orkiman/glueControllerEsp32S3_48V/hardware/schematics.pdf

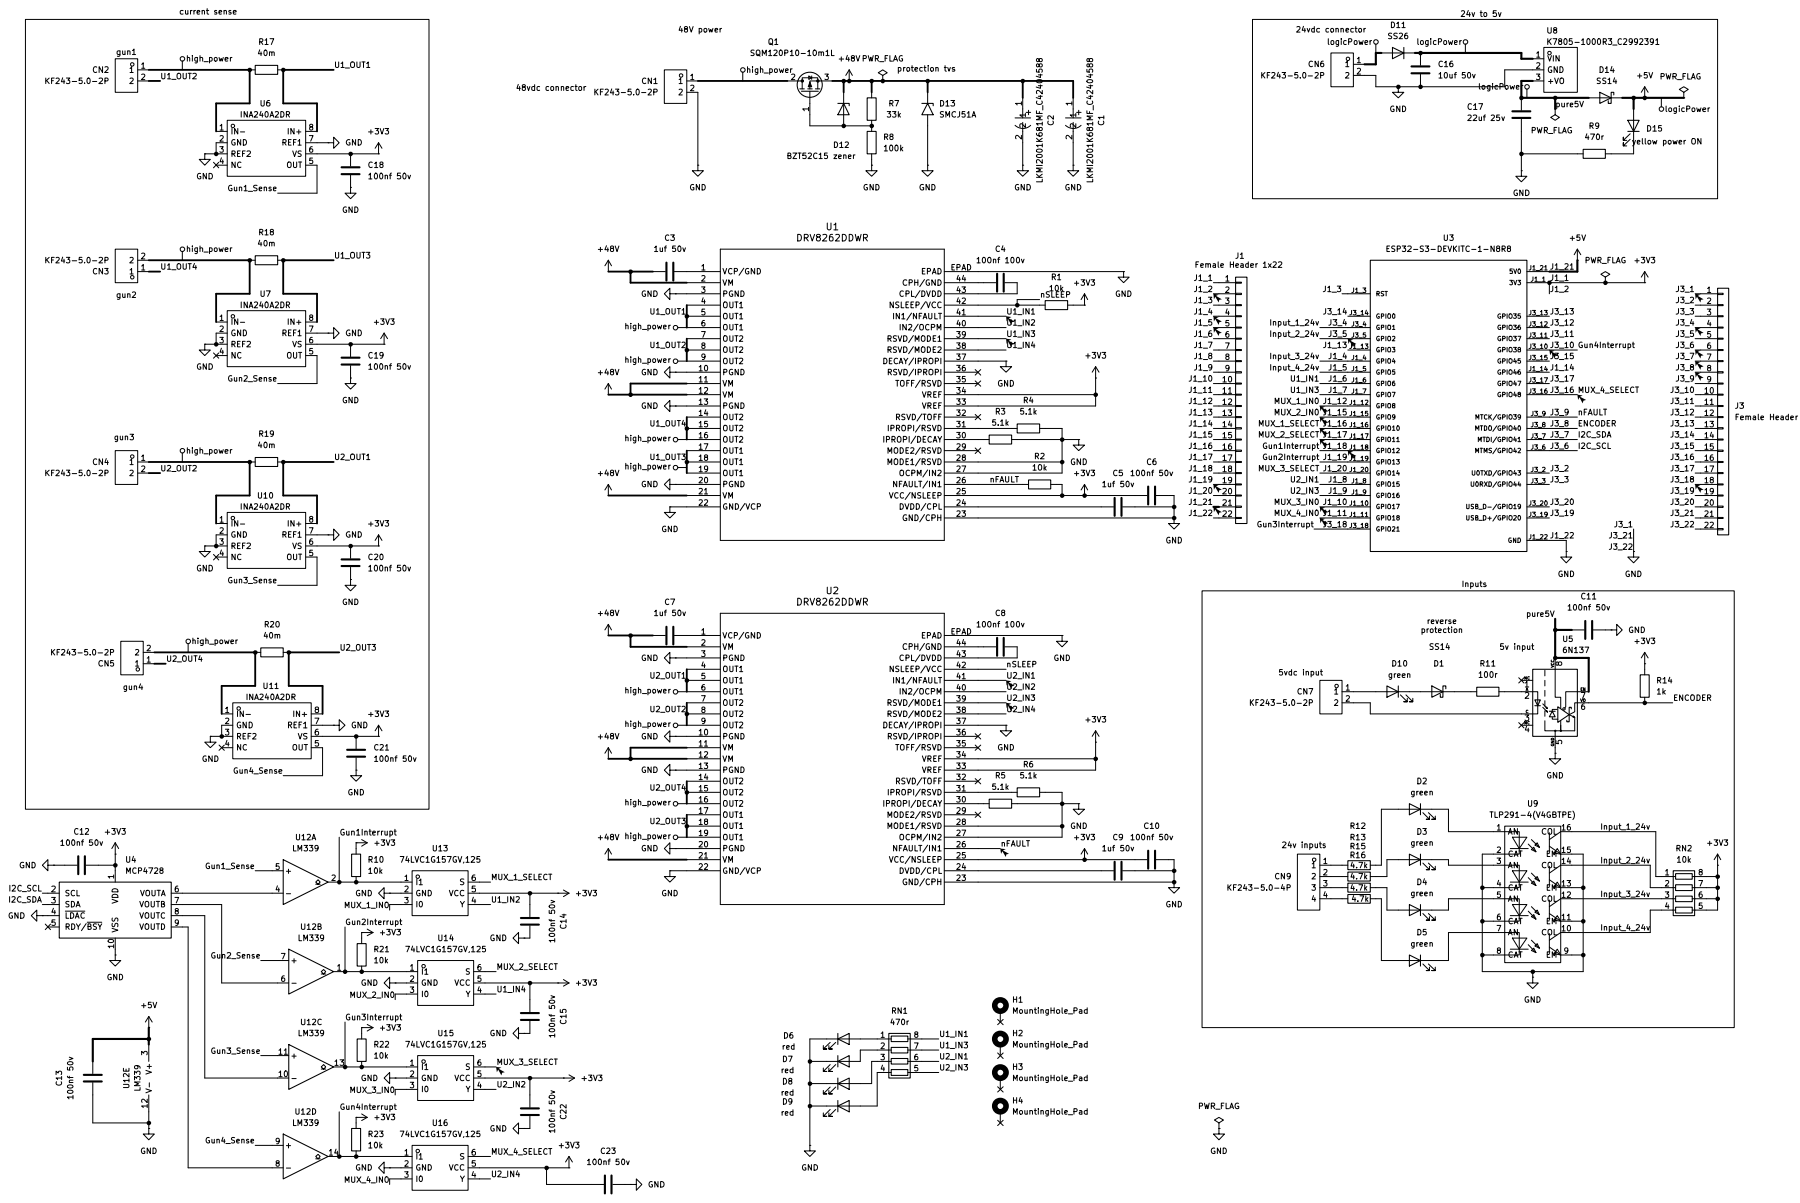
[picture p1: page 1]
