orkiman/glueControllerEsp32S3_48V/hardware/coldGlueEsp32HardwareComperator080426.kicad_pcb

## KiCad design hardware/coldGlueEsp32HardwareComperator080426.kicad_pcb (2026-05-10)

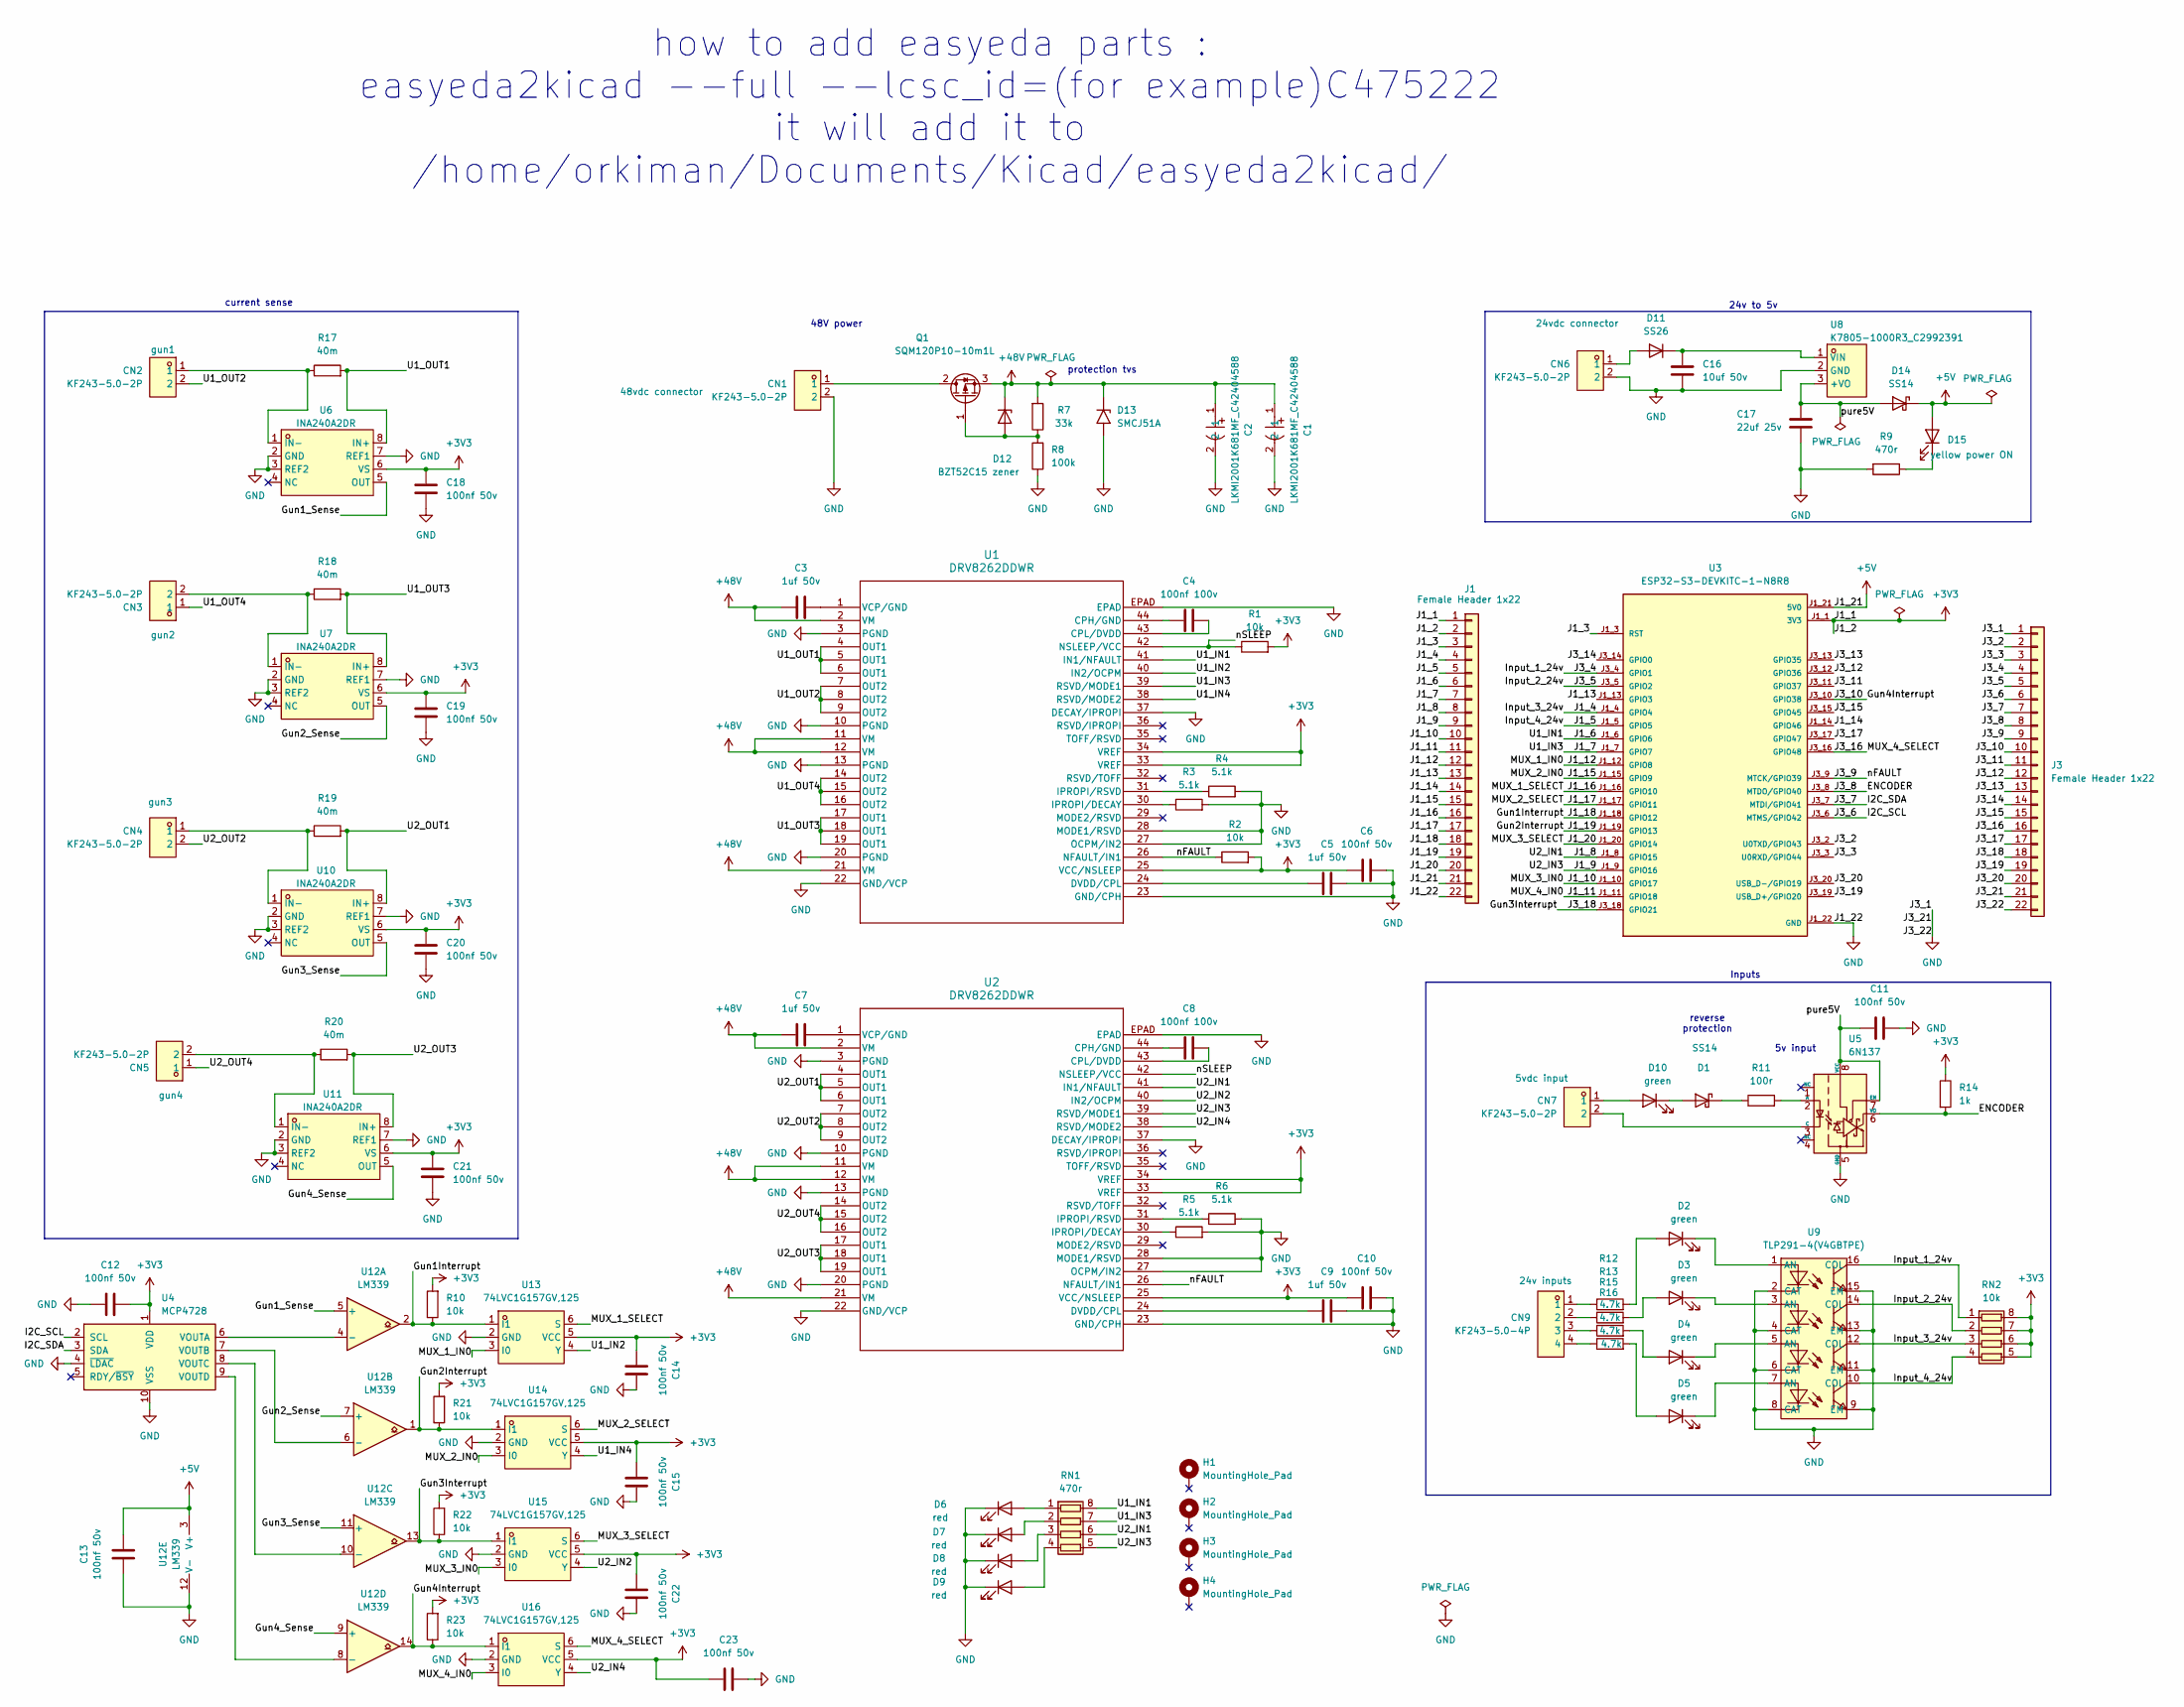
[picture p2: schematic coldGlueEsp32HardwareComperator080426.kicad_sch]

Parts:
C1, C2: LKMI2001K681MF_C42404588; CAP-TH_BD16.0-P7.50-D0.8-FD; LCSC_ALT C507603
C3, C5, C7, C9: 1uf 50v; C_0603_1608Metric; LCSC C15849
C4, C8: 100nf 100v; C_0805_2012Metric; LCSC C28233
C6, C10, C11, C12, C13, C14, C15, C18, C19, C20, C21, C22, C23: 100nf 50v; C_0603_1608Metric; LCSC C14663
C16: 10uf 50v; C_1206_3216Metric; LCSC C13585
C17: 22uf 25v; C_1206_3216Metric; LCSC C12891
CN1, CN2, CN3, CN4, CN5, CN6, CN7: KF243-5.0-2P; CONN-TH_P5.00_KF243-5.0-2P; LCSC C475222
CN9: KF243-5.0-4P; CONN-TH_4P-P5.00_KF243-5.0-4P; LCSC C475224
D1: SS14; D_SMA; part ss14; LCSC C2480
D2, D3, D4, D5, D10: green; LED_0805_2012Metric; LCSC C2297
D6, D7, D8, D9: red; LED_0805_2012Metric; LCSC C84256
D11: SS26; D_SMA; part ss26; LCSC C14238
D12: BZT52C15 zener; D_SOD-123; LCSC C2104
D13: SMCJ51A; D_SMC; LCSC C438115
D14: SS14; D_SMA; LCSC C2480
D15: yellow power ON; LED_0805_2012Metric; LCSC C2296
H1, H2, H3, H4: MountingHole_Pad; MountingHole_3.2mm_M3_Pad
J1, J3: Female Header 1x22; PinSocket_1x22_P2.54mm_Vertical; LCSC_ALT C47940(40p)
Q1: SQM120P10-10m1L; TO-263-2; LCSC_ALT C468007
R1, R2, R10, R21, R22, R23: 10k; R_0603_1608Metric; LCSC C25804
R3, R4, R5, R6: 5.1k; R_0603_1608Metric; LCSC C23186
R7: 33k; R_0805_2012Metric; LCSC C17633
R8: 100k; R_0805_2012Metric; LCSC C25611
R9: 470r; R_0603_1608Metric; LCSC C23179
R11: 100r; R_0603_1608Metric; LCSC C22775
R12, R13, R15, R16: 4.7k; R_1206_3216Metric; LCSC C17936
R14: 1k; R_0603_1608Metric; LCSC C21190
R17, R18, R19, R20: 40m; R_2512_6332Metric; LCSC C459685
RN1: 470r; R_Array_Convex_4x0603; LCSC_ALT C25510
RN2: 10k; R_Array_Convex_4x0603; LCSC_ALT C29718
U1, U2: DRV8262DDWR; HTSSOP44-DDW_TEX; LCSC C22427252
U3: ESP32-S3-DEVKITC-1-N8R8; XCVR_ESP32-S3-DEVKITC-1-N8R2; PARTREV V1
U4: MCP4728; MSOP-10_3x3mm_P0.5mm; LCSC C478093
U5: 6N137; SMDIP-8_W9.53mm; LCSC C16496
U6, U7, U10, U11: INA240A2DR; SOIC-8_L4.9-W3.9-P1.27-LS6.0-BL; LCSC C2060768
U8: K7805-1000R3_C2992391; PWRM-TH_YLPTEC_K78XX-1000R3; LCSC C2992391
U9: TLP291-4(V4GBTPE); SOP-16_L10.3-W4.4-P1.27-LS7.0-BL; LCSC C2848503
U12: LM339; SOIC-14_3.9x8.7mm_P1.27mm; LCSC C7948
U13, U14, U15, U16: 74LVC1G157GV,125; TSOP-6_L3.0-W1.5-P0.95-LS2.8-BR; MPN 74LVC1G157GV,125; LCSC C503437

Connections:
+3V3: C6.1, C10.1, C12.2, C14.1, C15.1, C18.1, C19.1, C20.1, C21.1, C22.1, C23.1, J1.1, J1.2, R1.2, R2.2, R10.2, R14.1, R21.2, R22.2, R23.2, RN2.5 (R4.2), RN2.6 (R3.2), RN2.7 (R2.2), RN2.8 (R1.2), U1.25 (VCC/NSLEEP), U1.33 (VREF), U1.34 (VREF), U2.25 (VCC/NSLEEP), U2.33 (VREF), U2.34 (VREF), U3.J1_1 (3V3), U3.J1_2 (3V3), U4.1 (VDD), U6.6 (VS), U7.6 (VS), U10.6 (VS), U11.6 (VS), U13.5 (VCC), U14.5 (VCC), U15.5 (VCC), U16.5 (VCC)
+5V: C13.2, D14.1 (K), D15.2 (A), J1.21, U3.J1_21 (5V0), U12.3 (V+)
+48V: C1.1, C2.1, C3.1, C7.1, D12.1 (K), D13.1 (A1), Q1.3 (S), R7.2, U1.2 (VM), U1.11 (VM), U1.12 (VM), U1.21 (VM), U2.2 (VM), U2.11 (VM), U2.12 (VM), U2.21 (VM)
/ENCODER: J3.8, R14.2, U3.J3_8 (MTDO/GPIO40), U5.6 (VO)
/Gun1Interrupt: J1.18, R10.1, U3.J1_18 (GPIO12), U12.2, U13.1 (I1)
/Gun1_Sense: U6.5 (OUT), U12.5 (+)
/Gun2Interrupt: J1.19, R21.1, U3.J1_19 (GPIO13), U12.1, U14.1 (I1)
/Gun2_Sense: U7.5 (OUT), U12.7 (+)
/Gun3Interrupt: J3.18, R22.1, U3.J3_18 (GPIO21), U12.13, U15.1 (I1)
/Gun3_Sense: U10.5 (OUT), U12.11 (+)
/Gun4Interrupt: J3.10, R23.1, U3.J3_10 (GPIO38), U12.14, U16.1 (I1)
/Gun4_Sense: U11.5 (OUT), U12.9 (+)
/I2C_SCL: J3.6, U3.J3_6 (MTMS/GPIO42), U4.2 (SCL)
/I2C_SDA: J3.7, U3.J3_7 (MTDI/GPIO41), U4.3 (SDA)
/Input_1_24v: J3.4, RN2.1 (R1.1), U3.J3_4 (GPIO1), U9.16 (COL)
/Input_2_24v: J3.5, RN2.2 (R2.1), U3.J3_5 (GPIO2), U9.14 (COL)
/Input_3_24v: J1.4, RN2.3 (R3.1), U3.J1_4 (GPIO4), U9.12 (COL)
/Input_4_24v: J1.5, RN2.4 (R4.1), U3.J1_5 (GPIO5), U9.10 (COL)
/J1_3: J1.3, U3.J1_3 (RST)
/J1_6: J1.6, RN1.8 (R1.2), U1.41 (IN1/NFAULT), U3.J1_6 (GPIO6)
/J1_7: J1.7, RN1.7 (R2.2), U1.39 (RSVD/MODE1), U3.J1_7 (GPIO7)
/J1_8: J1.8, RN1.6 (R3.2), U2.41 (IN1/NFAULT), U3.J1_8 (GPIO15)
/J1_9: J1.9, RN1.5 (R4.2), U2.39 (RSVD/MODE1), U3.J1_9 (GPIO16)
/J1_10: J1.10, U3.J1_10 (GPIO17), U15.3 (I0)
/J1_11: J1.11, U3.J1_11 (GPIO18), U16.3 (I0)
/J1_12: J1.12, U3.J1_12 (GPIO8), U13.3 (I0)
/J1_13: J1.13, U3.J1_13 (GPIO3)
/J1_14: J1.14, U3.J1_14 (GPIO46)
/J1_15: J1.15, U3.J1_15 (GPIO9), U14.3 (I0)
/J1_16: J1.16, U3.J1_16 (GPIO10), U13.6 (S)
/J1_17: J1.17, U3.J1_17 (GPIO11), U14.6 (S)
/J1_20: J1.20, U3.J1_20 (GPIO14), U15.6 (S)
/J3_2: J3.2, U3.J3_2 (U0TXD/GPIO43)
/J3_3: J3.3, U3.J3_3 (U0RXD/GPIO44)
/J3_9: J3.9, R2.1, U1.26 (NFAULT/IN1), U2.26 (NFAULT/IN1), U3.J3_9 (MTCK/GPIO39)
/J3_11: J3.11, U3.J3_11 (GPIO37)
/J3_12: J3.12, U3.J3_12 (GPIO36)
/J3_13: J3.13, U3.J3_13 (GPIO35)
/J3_14: J3.14, U3.J3_14 (GPIO0)
/J3_15: J3.15, U3.J3_15 (GPIO45)
/J3_16: J3.16, U3.J3_16 (GPIO48), U16.6 (S)
/J3_17: J3.17, U3.J3_17 (GPIO47)
/J3_19: J3.19, U3.J3_19 (USB_D+/GPIO20)
/J3_20: J3.20, U3.J3_20 (USB_D-/GPIO19)
/U1_IN2: U1.40 (IN2/OCPM), U13.4 (Y)
/U1_IN4: U1.38 (RSVD/MODE2), U14.4 (Y)
/U1_OUT1: R17.2, U1.4 (OUT1), U1.5 (OUT1), U1.6 (OUT1), U6.8 (IN+)
/U1_OUT2: CN2.2, U1.7 (OUT2), U1.8 (OUT2), U1.9 (OUT2)
/U1_OUT3: R18.2, U1.17 (OUT1), U1.18 (OUT1), U1.19 (OUT1), U7.8 (IN+)
/U1_OUT4: CN3.1, U1.14 (OUT2), U1.15 (OUT2), U1.16 (OUT2)
/U2_IN2: U2.40 (IN2/OCPM), U15.4 (Y)
/U2_IN4: U2.38 (RSVD/MODE2), U16.4 (Y)
/U2_OUT1: R19.2, U2.4 (OUT1), U2.5 (OUT1), U2.6 (OUT1), U10.8 (IN+)
/U2_OUT2: CN4.2, U2.7 (OUT2), U2.8 (OUT2), U2.9 (OUT2)
/U2_OUT3: R20.2, U2.17 (OUT1), U2.18 (OUT1), U2.19 (OUT1), U11.8 (IN+)
/U2_OUT4: CN5.1, U2.14 (OUT2), U2.15 (OUT2), U2.16 (OUT2)
/nSLEEP: R1.1, U1.42 (NSLEEP/VCC), U2.42 (NSLEEP/VCC)
/pure5V: C11.1, C17.1, D14.2 (A), U5.7 (EN), U5.8 (VCC), U8.3 (+VO)
GND: C1.2, C2.2, C5.2, C6.2, C9.2, C10.2, C11.2, C12.1, C13.1, C14.2, C15.2, C16.2, C17.2, C18.2, C19.2, C20.2, C21.2, C22.2, C23.2, CN1.2, CN6.2, D6.1 (K), D7.1 (K), D8.1 (K), D9.1 (K), D13.2 (A2), J1.22, J3.1, J3.21, J3.22, R3.2, R4.2, R5.2, R6.2, R8.1, R9.2, U1.3 (PGND), U1.10 (PGND), U1.13 (PGND), U1.20 (PGND), U1.22 (GND/VCP), U1.23 (GND/CPH), U1.27 (OCPM/IN2), U1.28 (MODE1/RSVD), U1.37 (DECAY/IPROPI), U1.EPAD, U2.3 (PGND), U2.10 (PGND), U2.13 (PGND), U2.20 (PGND), U2.22 (GND/VCP), U2.23 (GND/CPH), U2.27 (OCPM/IN2), U2.28 (MODE1/RSVD), U2.37 (DECAY/IPROPI), U2.EPAD, U3.J1_22 (GND), U3.J3_1 (GND), U3.J3_21 (GND), U3.J3_22 (GND), U4.4 (~LDAC), U4.10 (VSS), U5.5 (GND), U6.2 (GND), U6.3 (REF2), U6.7 (REF1), U7.2 (GND), U7.3 (REF2), U7.7 (REF1), U8.2 (GND), U9.2 (CAT), U9.4 (CAT), U9.6 (CAT), U9.8 (CAT), U9.9 (EM), U9.11 (EM), U9.13 (EM), U9.15 (EM), U10.2 (GND), U10.3 (REF2), U10.7 (REF1), U11.2 (GND), U11.3 (REF2), U11.7 (REF1), U12.12 (V-), U13.2 (GND), U14.2 (GND), U15.2 (GND), U16.2 (GND)
unnamed: CN9.1, R12.1
unnamed: CN9.2, R13.1
unnamed: CN9.3, R15.1
unnamed: CN9.4, R16.1
unnamed: D1.2 (A), D10.1 (K)
unnamed: D1.1 (K), R11.1
unnamed: D2.2 (A), R12.2
unnamed: D2.1 (K), U9.1 (AN)
unnamed: D3.2 (A), R13.2
unnamed: D3.1 (K), U9.3 (AN)
unnamed: D4.2 (A), R15.2
unnamed: D4.1 (K), U9.5 (AN)
unnamed: D5.2 (A), R16.2
unnamed: D5.1 (K), U9.7 (AN)
unnamed: D6.2 (A), RN1.1 (R1.1)
unnamed: D7.2 (A), RN1.2 (R2.1)
unnamed: D8.2 (A), RN1.3 (R3.1)
unnamed: D9.2 (A), RN1.4 (R4.1)
unnamed: CN7.1, D10.2 (A)
unnamed: CN6.1, D11.2 (A)
unnamed: C16.1, D11.1 (K), U8.1 (VIN)
unnamed: D12.2 (A), Q1.1 (G), R7.1, R8.2
unnamed: D15.1 (K), R9.1
unnamed: CN1.1, Q1.2 (D)
unnamed: C4.1, U1.44 (CPH/GND)
unnamed: C4.2, U1.43 (CPL/DVDD)
unnamed: C5.1, U1.24 (DVDD/CPL)
unnamed: R3.1, U1.30 (IPROPI/DECAY)
unnamed: R4.1, U1.31 (IPROPI/RSVD)
unnamed: C3.2, U1.1 (VCP/GND)
unnamed: C8.1, U2.44 (CPH/GND)
unnamed: C8.2, U2.43 (CPL/DVDD)
unnamed: C9.1, U2.24 (DVDD/CPL)
unnamed: R5.1, U2.30 (IPROPI/DECAY)
unnamed: R6.1, U2.31 (IPROPI/RSVD)
unnamed: C7.2, U2.1 (VCP/GND)
unnamed: R11.2, U5.2 (A)
unnamed: CN7.2, U5.3 (C)
unnamed: CN2.1, R17.1, U6.1 (IN-)
unnamed: CN3.2, R18.1, U7.1 (IN-)
unnamed: CN4.1, R19.1, U10.1 (IN-)
unnamed: CN5.2, R20.1, U11.1 (IN-)
unnamed: U4.6 (VOUTA), U12.4 (-)
unnamed: U4.7 (VOUTB), U12.6 (-)
unnamed: U4.8 (VOUTC), U12.10 (-)
unnamed: U4.9 (VOUTD), U12.8 (-)

Notes on the sheet:
48V power
Inputs
reverse protection
how to add easyeda parts : easyeda2kicad --full --lcsc_id=(for example)C475222 it will add it to /home/orkiman/Documents/Kicad/easyeda2kicad/
24v to 5v
current sense
5v input
protection tvs

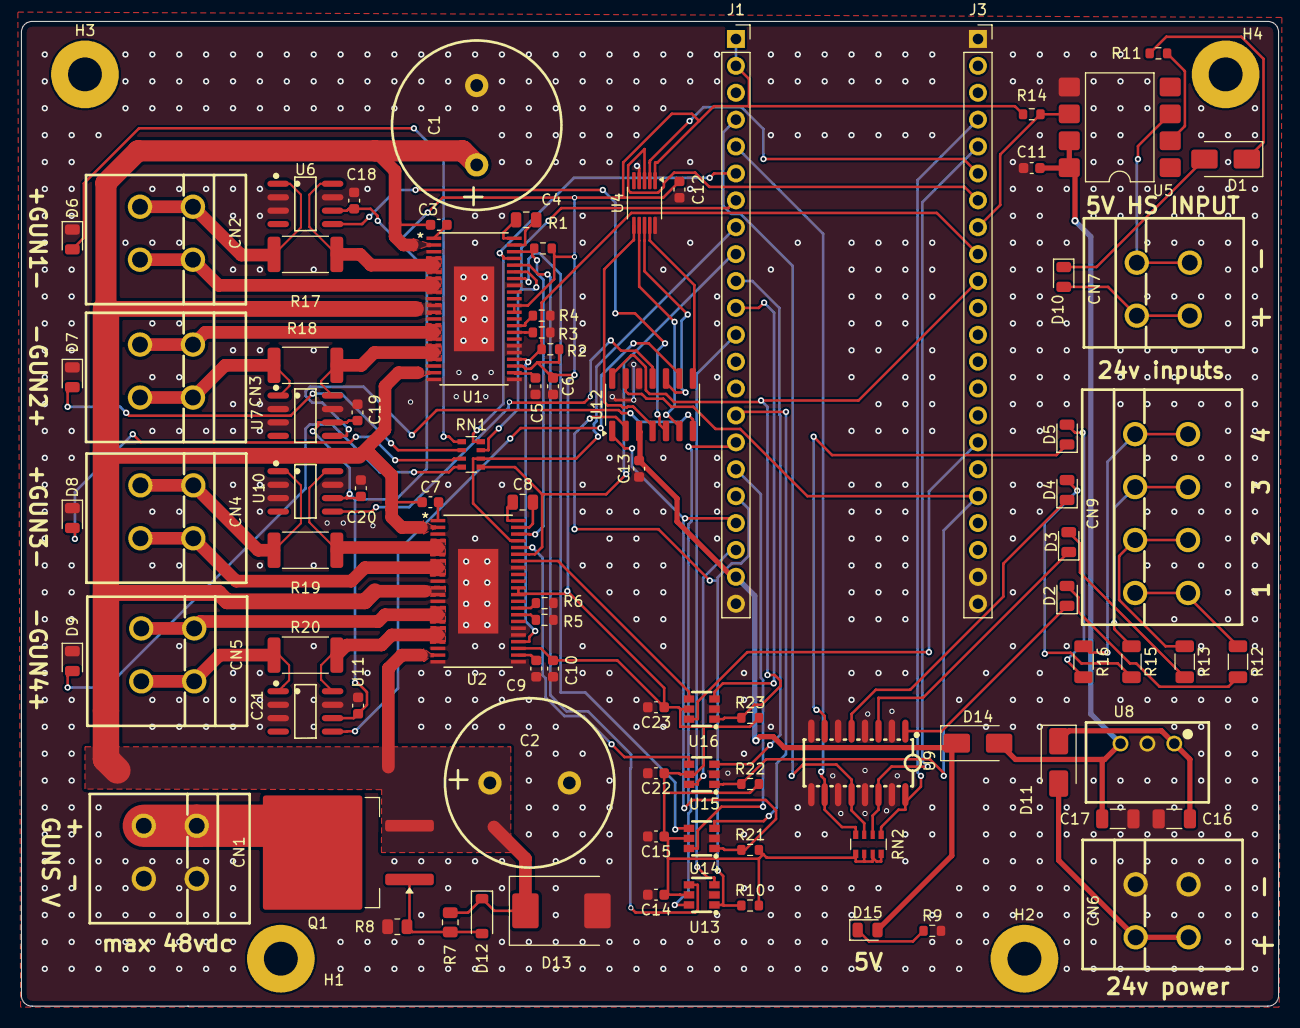
[picture p3: board coldGlueEsp32HardwareComperator080426.kicad_pcb from above]

Board: 2 copper layers, 118.7 x 93.0 mm, 93 parts (0 on the bottom side), 92 nets.
