orkiman/glueControllerEsp32S3_48V/src/rt/PatternScheduler.cpp

#include "PatternScheduler.h"
#include "GunSequencer.h"
#include "hw/Encoder.h"
#include "hw/Pins.h"
#include "config/Config.h"
#include "comms/Events.h"
#include "comms/LiveSync.h"

#include <atomic>
#include <freertos/FreeRTOS.h>
#include <freertos/task.h>
#include <esp_timer.h>

namespace pattern {

// ---------------- per-sheet, per-gun runtime instance ----------------
struct SheetGunInstance {
    uint32_t edgePulse;       // encoder pulse count at photocell leading edge
    uint16_t elemIdx;         // current element index within pattern
    uint16_t dotIdx;          // dot index within current dots-element
    bool     lineOpen;        // currently mid-line (line mode)
};

static constexpr uint8_t SHEET_QUEUE_DEPTH = 4;

struct GunQueue {
    SheetGunInstance ring[SHEET_QUEUE_DEPTH];
    uint8_t head = 0;         // index of oldest sheet
    uint8_t size = 0;
};

static GunQueue              s_q[pins::NUM_GUNS];
static portMUX_TYPE          s_mux = portMUX_INITIALIZER_UNLOCKED;

// Lines mode: gun is inside a line region but held closed because speed is
// below min_speed_mm_s.  Re-opened when speed recovers.  patternTask-only.
static bool                  s_linePaused[pins::NUM_GUNS] = {};
// Drop id of the line this task has open on each gun (0 = none).
// patternTask-only.
static uint32_t              s_lineDrop[pins::NUM_GUNS] = {};

// Resume threshold = min speed * this, so a speed reading hovering right at
// the limit doesn't chatter the solenoid on/off.
static constexpr float       RESUME_HYSTERESIS = 1.05f;
// With min speed off (0), a line still closes when no encoder pulse arrived
// for this long: a standing conveyor must not get a puddle.
static constexpr int64_t     STOPPED_US = 200000;

// Last pattern seen per gun, to detect edits.  patternTask-only.
static uint32_t              s_seenGeneration = 0;
static cfg::GunPattern       s_seenPattern[pins::NUM_GUNS];

// ---------------- encoder watch (supervisor tick, every 50 us) ----------------
// patternTask publishes the next due pulse of each gun's head sheet and the
// end pulse of each line it has open.  The supervisor tick compares them with
// the encoder: it wakes the task at the due pulse (instead of on the next
// 1 ms tick) and closes a line at its end pulse itself, so a line ends on
// time even if the task is late.  Task and tick both run on Core 1; s_mux
// keeps the fields consistent.
struct EncoderWatch {
    volatile uint32_t duePulse;
    volatile uint32_t lineEndPulse;
    volatile uint32_t lineDrop;
    volatile bool     dueArmed;
    volatile bool     lineArmed;
};
static EncoderWatch          s_watch[pins::NUM_GUNS];
static TaskHandle_t          s_task = nullptr;

// ---------------- cached config scalars ----------------
static std::atomic<float>    s_pulsesPerMm{12.34f};
static std::atomic<float>    s_offsetMm{250.0f};

// ---------------- calibration state ----------------
enum class CalibState : uint8_t { Idle = 0, ArmedLeading = 1, ArmedTrailing = 2 };
static std::atomic<CalibState> s_calib{CalibState::Idle};
static std::atomic<float>      s_calibPaperLen{0.0f};
static std::atomic<uint32_t>   s_calibLeadPulse{0};
static std::atomic<uint32_t>   s_calibPulses{0};      // set by falling-edge ISR
static std::atomic<bool>       s_calibDone{false};    // -> finishCalibration()

// ---------------- speed estimation ----------------
// Two independent measurements, both from polling the PCNT count in
// patternTask (no per-pulse interrupt):
//  - Display speed: pulses over a 300 ms sliding window, sampled every 10 ms.
//    Smooth, shown in GUI / web.  Too laggy for the safety gate.
//  - Safety gate (lines min speed): every count change seen by the ~1 ms poll
//    is logged with its poll time t and the poll gap d -- the pulse happened
//    in (t - d, t].  The gate works on guaranteed bounds from that log, so it
//    never trips on quantisation and reacts within one pulse period.
static constexpr uint8_t  SPEED_SAMPLES   = 30;        // x 10 ms = 300 ms
static constexpr int64_t  SPEED_SAMPLE_US = 10000;
static constexpr uint8_t  EDGE_LOG        = 64;
static constexpr int64_t  GATE_WINDOW_US  = 30000;

struct SpeedSample { uint32_t count; int64_t tUs; };
struct EdgeRec     { uint32_t count; int64_t tUs; int64_t dUs; };

// patternTask-only state.
static SpeedSample s_samples[SPEED_SAMPLES + 1];
static uint8_t     s_sampleHead = 0;         // newest
static uint8_t     s_sampleCount = 0;
static EdgeRec     s_edges[EDGE_LOG];
static uint8_t     s_edgeHead = 0;           // newest
static uint8_t     s_edgeCount = 0;

static std::atomic<float>     s_lastSpeedMmS{0.0f};
static std::atomic<uint32_t>  s_maxLoopGapUs{0};
static std::atomic<uint32_t>  s_maxEventLatePulses{0};
static std::atomic<uint32_t>  s_patternEvents{0};
static std::atomic<uint32_t>  s_sheetQueueOverflows{0};
static std::atomic<uint32_t>  s_sheetCount{0};      // sheets seen while active
static_assert(std::atomic<uint32_t>::is_always_lock_free);

// ---------------- helpers ----------------
static inline void updateMax(std::atomic<uint32_t>& target, uint32_t value) {
    uint32_t current = target.load(std::memory_order_relaxed);
    while (value > current &&
           !target.compare_exchange_weak(current, value, std::memory_order_relaxed)) {}
}

static inline float pulsesToMm(uint32_t p) {
    float ppm = s_pulsesPerMm.load(std::memory_order_acquire);
    return (ppm > 0.0f) ? ((float)p / ppm) : 0.0f;
}

static inline uint32_t mmToPulses(float mm) {
    float ppm = s_pulsesPerMm.load(std::memory_order_acquire);
    float p = mm * ppm;
    if (p < 0.0f) p = 0.0f;
    return (uint32_t)(p + 0.5f);
}

// ---------------- speed monitoring (patternTask context) ----------------
// Push a 300 ms-window sample and return the window's average speed (mm/s).
static float sampleDisplaySpeed(uint32_t count, int64_t nowUs) {
    s_sampleHead = (s_sampleHead + 1) % (SPEED_SAMPLES + 1);
    s_samples[s_sampleHead] = { count, nowUs };
    if (s_sampleCount < SPEED_SAMPLES + 1) s_sampleCount++;
    if (s_sampleCount < 2) return 0.0f;

    const SpeedSample& oldest =
        s_samples[(s_sampleHead + SPEED_SAMPLES + 2 - s_sampleCount) % (SPEED_SAMPLES + 1)];
    float sec = (float)(nowUs - oldest.tUs) * 1e-6f;
    return (sec > 0.0f) ? pulsesToMm(count - oldest.count) / sec : 0.0f;
}

static void logEdge(uint32_t count, int64_t tUs, int64_t dUs) {
    s_edgeHead = (s_edgeHead + 1) % EDGE_LOG;
    s_edges[s_edgeHead] = { count, tUs, dUs };
    if (s_edgeCount < EDGE_LOG) s_edgeCount++;
}

// Lines min-speed verdict.  Neither flag set = ambiguous (speed close to the
// limit); the caller keeps its current state, which is the hysteresis.
struct SpeedGate { bool tooSlow; bool canResume; };

static SpeedGate speedGate(int64_t nowUs, float minSpeed) {
    if (minSpeed <= 0.0f) {
        bool stopped = s_edgeCount == 0 || nowUs - s_edges[s_edgeHead].tUs > STOPPED_US;
        return { stopped, !stopped };
    }
    float ppm = s_pulsesPerMm.load(std::memory_order_acquire);
    if (ppm <= 0.0f || s_edgeCount == 0) return { true, false };

    const EdgeRec& newest = s_edges[s_edgeHead];

    // 1) No pulse for longer than one pulse period at minSpeed: the speed is
    //    below minSpeed right now (poll time <= true time since the pulse).
    float gapAtMinUs = 1e6f / (ppm * minSpeed);
    if ((float)(nowUs - newest.tUs) > gapAtMinUs) return { true, false };

    // 2) Reference edge: oldest one inside the gate window, or the one just
    //    before `newest` if the window holds only `newest`.
    const EdgeRec* old = nullptr;
    for (uint8_t i = 1; i < s_edgeCount; ++i) {
        const EdgeRec& e = s_edges[(s_edgeHead + EDGE_LOG - i) % EDGE_LOG];
        if (old && nowUs - e.tUs > GATE_WINDOW_US) break;
        old = &e;
    }
    if (!old) return { false, false };

    float pulses = (float)(newest.count - old->count);
    // Upper bound on speed between the two edges -> certainly too slow?
    float minDurUs = (float)(newest.tUs - old->tUs - newest.dUs);
    bool  slow = minDurUs > 0.0f && pulses * 1e6f / (ppm * minDurUs) < minSpeed;
    // Lower bound on speed from the reference edge until now -> certainly fast?
    float maxDurUs = (float)(nowUs - old->tUs + old->dUs);
    bool  fast = pulses * 1e6f / (ppm * maxDurUs) >= minSpeed * RESUME_HYSTERESIS;
    return { slow, !slow && fast };
}

// Compute the absolute pulse count of the *next* event for one sheet on one gun.
// Returns false if the sheet has no remaining events on this gun (instance done).
static bool nextEventPulse(uint8_t g, const SheetGunInstance& s,
                           uint32_t& outPulse, uint8_t& outAction)
{
    const cfg::GunPattern& gp = cfg::Config::active()->pattern[g];
    if (s.elemIdx >= gp.count || gp.type == cfg::PatternType::None) return false;

    const cfg::PatternElement& e = gp.elems[s.elemIdx];
    float ppm     = s_pulsesPerMm.load(std::memory_order_acquire);
    float offset  = s_offsetMm.load   (std::memory_order_acquire);
    uint32_t base = s.edgePulse + (uint32_t)((offset) * ppm + 0.5f);

    if (gp.type == cfg::PatternType::Lines) {
        if (!s.lineOpen) {
            outPulse  = base + (uint32_t)(e.start_mm * ppm + 0.5f);
            outAction = 1;    // open
        } else {
            outPulse  = base + (uint32_t)(e.end_mm * ppm + 0.5f);
            outAction = 2;    // close
        }
        return true;
    }
    // Dots
    float dotMm = e.start_mm + (float)s.dotIdx * e.spacing_mm;
    if (dotMm > e.end_mm + 0.0001f) return false;     // shouldn't happen, defensive
    outPulse  = base + (uint32_t)(dotMm * ppm + 0.5f);
    outAction = 0;
    return true;
}

// Advance instance past the action that just fired.
static void advanceInstance(uint8_t g, SheetGunInstance& s, uint8_t action) {
    const cfg::GunPattern& gp = cfg::Config::active()->pattern[g];
    if (s.elemIdx >= gp.count) return;
    const cfg::PatternElement& e = gp.elems[s.elemIdx];

    if (gp.type == cfg::PatternType::Lines) {
        if (action == 1) {           // just opened
            s.lineOpen = true;
        } else {                     // just closed -> next element
            s.lineOpen = false;
            s.elemIdx++;
        }
    } else { // Dots
        s.dotIdx++;
        float nextMm = e.start_mm + (float)s.dotIdx * e.spacing_mm;
        if (nextMm > e.end_mm + 0.0001f) {
            s.dotIdx  = 0;
            s.elemIdx++;
        }
    }
}

static bool instanceDone(uint8_t g, const SheetGunInstance& s) {
    const cfg::GunPattern& gp = cfg::Config::active()->pattern[g];
    return s.elemIdx >= gp.count || gp.type == cfg::PatternType::None;
}

// ---------------- ISR-context photocell hook ----------------
void IRAM_ATTR onPhotocellEdge(uint32_t pulseAtEdge) {
    // Calibration takes priority over normal triggering.
    CalibState cs = s_calib.load(std::memory_order_acquire);
    if (cs == CalibState::ArmedLeading) {
        s_calibLeadPulse.store(pulseAtEdge, std::memory_order_release);
        s_calib.store(CalibState::ArmedTrailing, std::memory_order_release);
        return;
    }

    if (!cfg::g_sys.active.load(std::memory_order_acquire)) return;
    if ( cfg::g_sys.fault .load(std::memory_order_acquire)) return;

    s_sheetCount.fetch_add(1, std::memory_order_relaxed);

    portENTER_CRITICAL_SAFE(&s_mux);
    for (uint8_t g = 0; g < pins::NUM_GUNS; ++g) {
        GunQueue& q = s_q[g];
        if (q.size >= SHEET_QUEUE_DEPTH) {
            s_sheetQueueOverflows.fetch_add(1, std::memory_order_relaxed);
            continue;
        }
        uint8_t slot = (q.head + q.size) % SHEET_QUEUE_DEPTH;
        q.ring[slot] = SheetGunInstance{ pulseAtEdge, 0, 0, false };
        q.size++;
    }
    portEXIT_CRITICAL_SAFE(&s_mux);

    // Let the task plan the new sheet now (also called from sw_trigger, a task).
    if (!s_task) return;
    if (xPortInIsrContext()) {
        BaseType_t hp = pdFALSE;
        vTaskNotifyGiveFromISR(s_task, &hp);
        if (hp) portYIELD_FROM_ISR();
    } else {
        xTaskNotifyGive(s_task);
    }
}

// Supervisor tick hook (Core 1 interrupt): see EncoderWatch.
static void IRAM_ATTR tickHook(BaseType_t* hp) {
    uint32_t now = encoder::pulseCount();
    uint32_t closeDrop[pins::NUM_GUNS] = {};
    bool     wake = false;
    portENTER_CRITICAL_ISR(&s_mux);
    for (uint8_t g = 0; g < pins::NUM_GUNS; ++g) {
        EncoderWatch& w = s_watch[g];
        if (w.lineArmed && (int32_t)(now - w.lineEndPulse) >= 0) {
            w.lineArmed  = false;
            closeDrop[g] = w.lineDrop;
            wake = true;
        }
        if (w.dueArmed && (int32_t)(now - w.duePulse) >= 0) {
            w.dueArmed = false;
            wake = true;
        }
    }
    portEXIT_CRITICAL_ISR(&s_mux);
    for (uint8_t g = 0; g < pins::NUM_GUNS; ++g) {
        if (closeDrop[g]) seq::closeIfDrop(g, closeDrop[g]);
    }
    if (wake && s_task) vTaskNotifyGiveFromISR(s_task, hp);
}

// ---------------- encoder watch updates (task context) ----------------
static void watchDue(uint8_t g, bool armed, uint32_t pulse) {
    portENTER_CRITICAL(&s_mux);
    s_watch[g].duePulse = pulse;
    s_watch[g].dueArmed = armed;
    portEXIT_CRITICAL(&s_mux);
}

static void watchLineEnd(uint8_t g, uint32_t endPulse, uint32_t drop) {
    portENTER_CRITICAL(&s_mux);
    s_watch[g].lineEndPulse = endPulse;
    s_watch[g].lineDrop     = drop;
    s_watch[g].lineArmed    = true;
    portEXIT_CRITICAL(&s_mux);
}

static void unwatchLineEnd(uint8_t g) {
    portENTER_CRITICAL(&s_mux);
    s_watch[g].lineArmed = false;
    portEXIT_CRITICAL(&s_mux);
}

void IRAM_ATTR onPhotocellFallingEdge(uint32_t pulseAtEdge) {
    if (s_calib.load(std::memory_order_acquire) != CalibState::ArmedTrailing) return;

    // Integer only: the FPU is off in ISR context.  patternTask does the
    // pulses / length division (finishCalibration).
    uint32_t lead = s_calibLeadPulse.load(std::memory_order_acquire);
    s_calibPulses.store(pulseAtEdge - lead, std::memory_order_release);
    s_calib.store(CalibState::Idle, std::memory_order_release);
    s_calibDone.store(true, std::memory_order_release);
}

// Task context (patternTask): turn the measured pulse count into pulses/mm.
// 0 = nothing counted (encoder not moving / wrong source).
static void finishCalibration() {
    uint32_t pulses = s_calibPulses.load(std::memory_order_acquire);
    float    L      = s_calibPaperLen.load(std::memory_order_acquire);
    float    ppm    = (L > 0.0f) ? (float)pulses / L : 0.0f;

    // Applying pulses_per_mm, reporting and leaving calibration mode happen
    // in livesync::service under the shared edit lock, so this never races a
    // UART / web edit of the scratch buffer.
    livesync::postCalibration(ppm);
}

// ---------------- sheet queue access (patternTask) ----------------
static bool headOf(uint8_t g, SheetGunInstance& out) {
    portENTER_CRITICAL(&s_mux);
    bool have = s_q[g].size > 0;
    if (have) out = s_q[g].ring[s_q[g].head];
    portEXIT_CRITICAL(&s_mux);
    return have;
}

// Pop the head instance; returns the new head, if any.
static bool popHead(uint8_t g, SheetGunInstance& out) {
    portENTER_CRITICAL(&s_mux);
    if (s_q[g].size > 0) {
        s_q[g].head = (s_q[g].head + 1) % SHEET_QUEUE_DEPTH;
        s_q[g].size--;
    }
    bool more = s_q[g].size > 0;
    if (more) out = s_q[g].ring[s_q[g].head];
    portEXIT_CRITICAL(&s_mux);
    return more;
}

static void writeBackHead(uint8_t g, const SheetGunInstance& inst) {
    portENTER_CRITICAL(&s_mux);
    if (s_q[g].size > 0) s_q[g].ring[s_q[g].head] = inst;
    portEXIT_CRITICAL(&s_mux);
}

// ---------------- lines (patternTask) ----------------
// Long on-time for a line: it is closed by position; this is only the ceiling.
static constexpr uint32_t LINE_CEILING_MS = 5000;

// Encoder pulse where the line the instance is in (or about to open) ends.
static uint32_t lineEndPulse(uint8_t g, const SheetGunInstance& s) {
    const cfg::GunPattern& gp = cfg::Config::active()->pattern[g];
    float ppm    = s_pulsesPerMm.load(std::memory_order_acquire);
    float offset = s_offsetMm.load   (std::memory_order_acquire);
    uint32_t base = s.edgePulse + (uint32_t)(offset * ppm + 0.5f);
    return base + (uint32_t)(gp.elems[s.elemIdx].end_mm * ppm + 0.5f);
}

// Open the line element the instance is at; the supervisor closes it at its
// end pulse.
static bool openLine(uint8_t g, const SheetGunInstance& inst) {
    uint32_t drop = 0;
    if (!seq::fire(g, LINE_CEILING_MS, &drop)) return false;
    s_lineDrop[g] = drop;
    watchLineEnd(g, lineEndPulse(g, inst), drop);
    return true;
}

// Close the line this task opened on gun g (no-op if none is open).
static void closeLine(uint8_t g) {
    unwatchLineEnd(g);
    if (s_lineDrop[g]) seq::closeIfDrop(g, s_lineDrop[g]);
    s_lineDrop[g] = 0;
}

static void endLine(uint8_t g) {
    closeLine(g);
    s_linePaused[g] = false;
}

// Drop gun g's in-flight sheets and close a line it has open.
static void resetGun(uint8_t g) {
    endLine(g);
    portENTER_CRITICAL(&s_mux);
    s_q[g].head = 0;
    s_q[g].size = 0;
    s_watch[g].dueArmed = false;
    portEXIT_CRITICAL(&s_mux);
}

// ---------------- pattern edits (patternTask) ----------------
static bool sameGeometry(const cfg::GunPattern& a, const cfg::GunPattern& b) {
    if (a.type != b.type || a.count != b.count) return false;
    for (uint8_t i = 0; i < a.count; ++i) {
        if (a.elems[i].start_mm   != b.elems[i].start_mm ||
            a.elems[i].end_mm     != b.elems[i].end_mm   ||
            a.elems[i].spacing_mm != b.elems[i].spacing_mm) return false;
    }
    return true;
}

static void rememberPatterns() {
    s_seenGeneration = cfg::Config::generation();
    const cfg::RuntimeConfig* c = cfg::Config::active();
    for (uint8_t g = 0; g < pins::NUM_GUNS; ++g) s_seenPattern[g] = c->pattern[g];
}

// A gun whose pattern shape changed starts over from the next sheet: its
// in-flight sheets were planned with the old shape (and an open line would
// have lost its close).  An on-time-only change keeps running.
static void checkPatternEdits() {
    if (cfg::Config::generation() == s_seenGeneration) return;
    s_seenGeneration = cfg::Config::generation();
    const cfg::RuntimeConfig* c = cfg::Config::active();
    for (uint8_t g = 0; g < pins::NUM_GUNS; ++g) {
        if (!sameGeometry(c->pattern[g], s_seenPattern[g])) resetGun(g);
        s_seenPattern[g] = c->pattern[g];
    }
}

// ---------------- PatternTask ----------------
// Fire every event of gun g's head sheet that has come due, run the lines
// min-speed gate, and hand the next due pulse to the supervisor tick.
static void serviceGun(uint8_t g, uint32_t now, const SpeedGate& gate) {
    SheetGunInstance peek;
    bool have = headOf(g, peek);
    if (!have) { endLine(g); watchDue(g, false, 0); return; }

    uint32_t evPulse = 0;
    bool     pending = false;
    while (have) {
        uint8_t action;
        if (!nextEventPulse(g, peek, evPulse, action)) {
            // Sheet done on this gun.  A line still open here lost its close
            // to a pattern change: close it now.
            if (peek.lineOpen) endLine(g);
            have = popHead(g, peek);
            continue;
        }
        int32_t latePulses = (int32_t)(now - evPulse);
        if (latePulses < 0) { pending = true; break; }   // not due yet
        updateMax(s_maxEventLatePulses, (uint32_t)latePulses);
        s_patternEvents.fetch_add(1, std::memory_order_relaxed);

        if (action == 0) {                       // dot (ignored while the gun is still open)
            seq::fire(g, 0);                     // on-time = pattern[g].on_timeout_ms
        } else if (action == 1) {                // open line; retried below if it cannot open now
            s_linePaused[g] = gate.tooSlow || !openLine(g, peek);
        } else {                                 // close line
            endLine(g);
        }
        advanceInstance(g, peek, action);
        writeBackHead(g, peek);
    }
    watchDue(g, pending, evPulse);

    // Lines speed gate.  `peek.lineOpen`: the head sheet is between start_mm
    // and end_mm of a line on this gun.  Below min speed the gun closes at
    // once; it re-opens when speed recovers while still inside the line.
    if (have && peek.lineOpen) {
        if (gate.tooSlow) {
            if (!s_linePaused[g]) { closeLine(g); s_linePaused[g] = true; }
        } else if (s_linePaused[g] && gate.canResume &&
                   (int32_t)(lineEndPulse(g, peek) - encoder::pulseCount()) > 0) {
            // fire() fails while the gun is still busy; retry next tick.
            if (openLine(g, peek)) s_linePaused[g] = false;
        }
    }
}

static void patternTask(void*) {
    uint32_t lastSeen     = encoder::pulseCount();
    int64_t  lastSampleUs = esp_timer_get_time();
    int64_t  lastLoopUs   = lastSampleUs;
    bool     wasActive    = false;
    rememberPatterns();

    for (;;) {
        uint32_t now = encoder::pulseCount();

        // --- speed monitoring ---
        int64_t nowUs = esp_timer_get_time();
        int64_t pollGapUs = nowUs - lastLoopUs;
        bool active  = cfg::g_sys.active.load(std::memory_order_acquire);
        bool stopped = wasActive && !active;
        if (active && wasActive) updateMax(s_maxLoopGapUs, (uint32_t)pollGapUs);
        lastLoopUs = nowUs;
        wasActive = active;
        if (now != lastSeen) {
            logEdge(now, nowUs, pollGapUs);
            lastSeen = now;
        }
        if (nowUs - lastSampleUs >= SPEED_SAMPLE_US) {
            s_lastSpeedMmS.store(sampleDisplaySpeed(now, nowUs), std::memory_order_release);
            lastSampleUs = nowUs;
        }
        if (s_calibDone.exchange(false, std::memory_order_acq_rel)) finishCalibration();

        if (!active) {
            // Stopped (command, watchdog, fault, safety stop): nothing in
            // flight survives into the next run.
            if (stopped) for (uint8_t g = 0; g < pins::NUM_GUNS; ++g) resetGun(g);
            ulTaskNotifyTake(pdTRUE, pdMS_TO_TICKS(5));
            continue;
        }

        checkPatternEdits();
        SpeedGate gate = speedGate(nowUs, cfg::Config::active()->min_speed_mm_s);
        for (uint8_t g = 0; g < pins::NUM_GUNS; ++g) serviceGun(g, now, gate);

        // Woken by the supervisor tick at the next due pulse (or a new
        // sheet); otherwise every 1 ms tick for the speed gate and display.
        ulTaskNotifyTake(pdTRUE, 1);
    }
}

// ---------------- public API ----------------
void onConfigApplied() {
    const cfg::RuntimeConfig* c = cfg::Config::active();
    s_pulsesPerMm.store(c->pulses_per_mm,       std::memory_order_release);
    s_offsetMm   .store(c->photocell_offset_mm, std::memory_order_release);
}

void onCalibArm(float paperLengthMm) {
    s_calibDone.store(false, std::memory_order_release);
    s_calibPaperLen.store(paperLengthMm, std::memory_order_release);
    s_calib.store(CalibState::ArmedLeading, std::memory_order_release);
}

void onCalibCancel() {
    s_calib.store(CalibState::Idle, std::memory_order_release);
    s_calibDone.store(false, std::memory_order_release);
}

void abortAll() {
    portENTER_CRITICAL(&s_mux);
    for (uint8_t g = 0; g < pins::NUM_GUNS; ++g) {
        s_q[g].head = 0;
        s_q[g].size = 0;
        s_watch[g].dueArmed  = false;
        s_watch[g].lineArmed = false;
    }
    portEXIT_CRITICAL(&s_mux);
    seq::abortAll();
}

float currentPosMm()   { return pulsesToMm(encoder::pulseCount()); }
float currentSpeedMmS(){ return s_lastSpeedMmS.load(std::memory_order_acquire); }
uint32_t sheetCount()  { return s_sheetCount.load(std::memory_order_relaxed); }
void resetSheetCount() { s_sheetCount.store(0, std::memory_order_relaxed); }
Metrics metrics() {
    return {
        s_maxLoopGapUs.load(std::memory_order_relaxed),
        s_maxEventLatePulses.load(std::memory_order_relaxed),
        s_patternEvents.load(std::memory_order_relaxed),
        s_sheetQueueOverflows.load(std::memory_order_relaxed),
    };
}

void init() {
    onConfigApplied();
    xTaskCreatePinnedToCore(patternTask, "pattern", 8192, nullptr, 7, &s_task, 1);
    seq::setTickHook(&tickHook);
}

} // namespace pattern
