orkiman/glueControllerEsp32S3_48V/src/comms/CommandDispatcher.cpp

#include "CommandDispatcher.h"
#include "config/Config.h"
#include "rt/Control.h"
#include "storage/ProgramStore.h"
#include "comms/Events.h"
#include "hw/Pins.h"

#include <Arduino.h>
#include <ArduinoJson.h>
#include <string.h>

namespace cmd {

// Source of the command currently being dispatched (valid under the lock).
static livesync::Source s_src = livesync::Source::Uart;

static inline void setStr(char* dst, size_t cap, const char* src) {
    if (!src) { dst[0] = '\0'; return; }
    strncpy(dst, src, cap - 1);
    dst[cap - 1] = '\0';
}

static inline Result makeResult(bool ok, const char* cmd, const char* reason = "") {
    Result r{};
    r.ok = ok;
    setStr(r.cmd, sizeof(r.cmd), cmd);
    setStr(r.reason, sizeof(r.reason), reason);
    return r;
}

static inline void feedWatchdog() {
    cfg::g_sys.lastCmdMs.store(millis(), std::memory_order_release);
}

static bool parsePatternElements(JsonArrayConst arr, cfg::PatternType type,
                                 cfg::GunPattern& out, const char*& reason) {
    if (arr.size() > cfg::MAX_PATTERN_ELEMENTS_PER_GUN) {
        reason = "too_many_elements"; return false;
    }
    out.type  = type;
    out.count = 0;
    for (JsonObjectConst el : arr) {
        if (!el["start"].is<float>() || !el["end"].is<float>()) {
            reason = "missing_start_end"; return false;
        }
        cfg::PatternElement& pe = out.elems[out.count];
        pe.start_mm   = el["start"].as<float>();
        pe.end_mm     = el["end"].as<float>();
        pe.spacing_mm = (type == cfg::PatternType::Dots)
                            ? el["spacing"].as<float>()
                            : 0.0f;
        if (pe.end_mm < pe.start_mm) { reason = "end_before_start"; return false; }
        if (type == cfg::PatternType::Dots && pe.spacing_mm <= 0.0f) {
            reason = "bad_spacing"; return false;
        }
        out.count++;
    }
    return true;
}

static Result handleSetActive(JsonDocument& doc) {
    if (!doc["active"].is<bool>()) {
        return makeResult(false, "set_active", "missing_active");
    }
    bool a = doc["active"].as<bool>();
    // Start / stop during calibration: the operator's command wins.
    rt::onCalibCancel(false);
    if (a && cfg::g_sys.fault.load()) {
        cfg::g_sys.fault.store(false);
    }
    rt::onSetActive(a);
    cfg::g_sys.active.store(a);
    return makeResult(true, "set_active");
}

static Result handleSetConfig(JsonDocument& doc) {
    cfg::RuntimeConfig* s = cfg::Config::editScratch();
    if (doc["pulses_per_mm"].is<float>())       s->pulses_per_mm       = doc["pulses_per_mm"];
    if (doc["min_speed_mm_s"].is<float>())      s->min_speed_mm_s      = doc["min_speed_mm_s"];
    if (doc["photocell_offset_mm"].is<float>()) s->photocell_offset_mm = doc["photocell_offset_mm"];
    if (doc["debounce_ms"].is<uint32_t>())      s->debounce_ms         = doc["debounce_ms"];
    if (doc["pick_current_a"].is<float>())      s->pick_current_a      = doc["pick_current_a"];
    if (doc["hold_current_a"].is<float>())      s->hold_current_a      = doc["hold_current_a"];
    if (doc["encoder_source"].is<uint8_t>())    s->encoder_source      = doc["encoder_source"];
    if (doc["photocell_invert"].is<bool>())     s->photocell_invert    = doc["photocell_invert"];
    if (doc["calib_paper_mm"].is<float>())      s->calib_paper_mm      = doc["calib_paper_mm"];

    const char* reason = nullptr;
    if      (s->pulses_per_mm  <= 0.0f)              reason = "bad_pulses_per_mm";
    else if (s->pick_current_a <= 0.0f)              reason = "bad_pick_current";
    else if (s->pick_current_a > cfg::MAX_PICK_CURRENT_A) reason = "pick_too_high";
    else if (s->hold_current_a <= 0.0f)              reason = "bad_hold_current";
    else if (s->hold_current_a > cfg::MAX_HOLD_CURRENT_A) reason = "hold_too_high";
    else if (s->hold_current_a >= s->pick_current_a) reason = "hold_ge_pick";
    else if (s->encoder_source > 1)                  reason = "bad_encoder_source";
    else if (s->calib_paper_mm <= 0.0f)              reason = "bad_paper_length";
    if (reason) {
        // Rejected: re-send the unchanged config so the PC drops its local edit.
        if (s_src == livesync::Source::Uart) evt::postConfig(cfg::Config::active());
        return makeResult(false, "set_config", reason);
    }

    cfg::Config::publish();
    rt::onConfigApplied();
    prog::markDirty();
    livesync::configChanged(s_src);
    return makeResult(true, "set_config");
}

static Result handleSetPatternImpl(JsonDocument& doc);

static Result handleSetPattern(JsonDocument& doc) {
    Result r = handleSetPatternImpl(doc);
    if (!r.ok && s_src == livesync::Source::Uart) {
        // Rejected: re-send the unchanged pattern so the PC drops its local edit.
        uint8_t gun = doc["gun"] | 0;
        if (gun >= 1 && gun <= pins::NUM_GUNS) {
            evt::postPattern(gun, &cfg::Config::active()->pattern[gun - 1]);
        }
    }
    return r;
}

static Result handleSetPatternImpl(JsonDocument& doc) {
    if (!doc["gun"].is<uint8_t>()) { return makeResult(false, "set_pattern","missing_gun"); }
    uint8_t gunOneBased = doc["gun"].as<uint8_t>();
    if (gunOneBased < 1 || gunOneBased > pins::NUM_GUNS) {
        return makeResult(false, "set_pattern","invalid_gun");
    }
    const char* typeStr = doc["type"] | "";
    cfg::PatternType type;
    if      (!strcmp(typeStr, "lines")) type = cfg::PatternType::Lines;
    else if (!strcmp(typeStr, "dots"))  type = cfg::PatternType::Dots;
    else if (!strcmp(typeStr, "none"))  type = cfg::PatternType::None;
    else { return makeResult(false, "set_pattern","bad_type"); }

    cfg::RuntimeConfig* s = cfg::Config::editScratch();
    cfg::GunPattern&    gp = s->pattern[gunOneBased - 1];

    if (type == cfg::PatternType::None) {
        gp.type  = cfg::PatternType::None;
        gp.count = 0;
    } else {
        JsonArrayConst arr = doc["elements"].as<JsonArrayConst>();
        if (arr.isNull()) { return makeResult(false, "set_pattern","missing_elements"); }

        const char* reason = nullptr;
        if (!parsePatternElements(arr, type, gp, reason)) {
            return makeResult(false, "set_pattern", reason ? reason : "parse_error");
        }
    }
    if (doc["on_timeout_ms"].is<float>()) {
        float ot = doc["on_timeout_ms"].as<float>();
        if (ot <= 0.0f) { return makeResult(false, "set_pattern","bad_on_timeout"); }
        gp.on_timeout_ms = ot;
    }
    cfg::Config::publish();
    prog::markDirty();
    livesync::patternChanged(gunOneBased, s_src);
    return makeResult(true, "set_pattern");
}

static Result handleCalibArm(JsonDocument& doc) {
    if (!doc["paper_length_mm"].is<float>()) {
        return makeResult(false, "calib_arm","missing_paper_length");
    }
    float L = doc["paper_length_mm"].as<float>();
    if (L <= 0.0f) { return makeResult(false, "calib_arm","bad_paper_length"); }
    rt::onCalibArm(L);
    return makeResult(true, "calib_arm");
}

static Result handleCalibCancel(JsonDocument&) {
    rt::onCalibCancel(true);      // back to the state from before arming
    return makeResult(true, "calib_cancel");
}

static Result handleListPrograms(JsonDocument&) {
    livesync::emitProgramsList();
    return makeResult(true, "list_programs");
}

static Result handleGetState(JsonDocument&) {
    livesync::emitFullState();
    return makeResult(true, "get_state");
}

static Result handleSaveProgram(JsonDocument& doc) {
    uint8_t id = doc["id"] | 0;
    const char* name = doc["name"] | "";
    if (!name[0]) { return makeResult(false, "save_program", "missing_name"); }
    uint8_t outId = 0;
    if (!prog::save(id, name, &outId)) {
        return makeResult(false, "save_program", "save_failed");
    }
    livesync::programsChanged();
    return makeResult(true, "save_program");
}

static Result handleLoadProgram(JsonDocument& doc) {
    uint8_t id = doc["id"] | 0;
    if (id == 0 || !prog::load(id)) {
        return makeResult(false, "load_program", "load_failed");
    }
    livesync::programLoaded();
    return makeResult(true, "load_program");
}

static Result handleRenameProgram(JsonDocument& doc) {
    uint8_t id = doc["id"] | 0;
    const char* name = doc["name"] | "";
    if (!name[0]) { return makeResult(false, "rename_program", "missing_name"); }
    if (!prog::rename(id, name)) {
        return makeResult(false, "rename_program", "rename_failed");
    }
    livesync::programsChanged();
    return makeResult(true, "rename_program");
}

static Result handleDeleteProgram(JsonDocument& doc) {
    uint8_t id = doc["id"] | 0;
    if (id == 0 || !prog::erase(id)) {
        return makeResult(false, "delete_program", "delete_failed");
    }
    // Deleting the active program loads another one, so resend everything.
    livesync::programLoaded();
    return makeResult(true, "delete_program");
}

static Result handleTestOpen(JsonDocument& doc) {
    if (!doc["gun"].is<uint8_t>()) { return makeResult(false, "test_open","missing_gun"); }
    uint8_t  gun     = doc["gun"].as<uint8_t>();
    uint32_t timeout = doc["timeout_ms"] | 1000u;
    if (gun > pins::NUM_GUNS)        { return makeResult(false, "test_open","invalid_gun"); }
    if (timeout == 0 || timeout > 30000u) {      // operator-set, max 30 s
        return makeResult(false, "test_open","bad_timeout");
    }
    if (cfg::g_sys.fault.load())     { return makeResult(false, "test_open","hardware_fault"); }
    // Gun tests run only while the machine is stopped.
    if (cfg::g_sys.active.load())      { return makeResult(false, "test_open","machine_active"); }
    if (cfg::g_sys.calibrating.load()) { return makeResult(false, "test_open","calibrating"); }
    rt::onTestOpen(gun, timeout);
    return makeResult(true, "test_open");
}

static Result handleTestClose(JsonDocument& doc) {
    uint8_t gun = doc["gun"] | 0;
    if (gun > pins::NUM_GUNS) { return makeResult(false, "test_close","invalid_gun"); }
    rt::onTestClose(gun);
    return makeResult(true, "test_close");
}

static Result handlePing(JsonDocument&) {
    return makeResult(true, "ping");
}

static Result handleSwTrigger(JsonDocument&) {
    if (cfg::g_sys.fault.load()) { return makeResult(false, "sw_trigger","hardware_fault"); }
    rt::onSwTrigger();
    return makeResult(true, "sw_trigger");
}

static Result handleResetSheetCount(JsonDocument&) {
    rt::onResetSheetCount();
    return makeResult(true, "reset_sheet_count");
}

static Result dispatchLocked(JsonDocument& doc);

Result dispatch(const char* line, size_t len, livesync::Source src) {
    JsonDocument doc;
    DeserializationError err = deserializeJson(doc, line, len);
    if (err) { return makeResult(false, "", "bad_json"); }

    feedWatchdog();
    livesync::Guard guard;
    s_src = src;
    return dispatchLocked(doc);
}

static Result dispatchLocked(JsonDocument& doc) {
    const char* command = doc["cmd"] | "";

    if      (!strcmp(command, "set_active"))      return handleSetActive(doc);
    else if (!strcmp(command, "set_config"))      return handleSetConfig(doc);
    else if (!strcmp(command, "set_pattern"))     return handleSetPattern(doc);
    else if (!strcmp(command, "calib_arm"))       return handleCalibArm(doc);
    else if (!strcmp(command, "calib_cancel"))    return handleCalibCancel(doc);
    else if (!strcmp(command, "test_open"))       return handleTestOpen(doc);
    else if (!strcmp(command, "test_close"))     return handleTestClose(doc);
    else if (!strcmp(command, "ping"))            return handlePing(doc);
    else if (!strcmp(command, "sw_trigger"))     return handleSwTrigger(doc);
    else if (!strcmp(command, "reset_sheet_count")) return handleResetSheetCount(doc);
    else if (!strcmp(command, "get_state"))      return handleGetState(doc);
    else if (!strcmp(command, "list_programs"))  return handleListPrograms(doc);
    else if (!strcmp(command, "save_program"))   return handleSaveProgram(doc);
    else if (!strcmp(command, "load_program"))   return handleLoadProgram(doc);
    else if (!strcmp(command, "rename_program"))  return handleRenameProgram(doc);
    else if (!strcmp(command, "delete_program"))  return handleDeleteProgram(doc);
    else                                          return makeResult(false, command, "unknown_cmd");
}

} // namespace cmd
