orkiman/glueControllerEsp32S3_48V/gui/app/state.py

"""Central application state.

The UI binds to signals here; commands flow back through `send_*` methods
which write to the link. Live publish — no Apply button. UI changes call
`set_*` methods which immediately marshal to set_config / set_pattern.

The controller is the single source of truth and is shared with the web UI.
On connect (and after a firmware reboot) we pull its state with get_state; any
change made from the web arrives as config / pattern / programs_list events.
"""
from __future__ import annotations

import logging
from dataclasses import dataclass, field
from typing import Any

from PySide6.QtCore import QObject, QTimer, Signal

from . import protocol as proto
from .admin import AdminMode
from .link_base import LinkBase


LOGGER = logging.getLogger("state")

# Log levels (see app/logs.py): INFO/WARNING go to glue.log, DEBUG only to
# debug.log in debug mode.
_ROUTINE_CMDS = {"get_state", "list_programs"}          # state sync, not operator actions
_ROUTINE_EVENTS = {"status", "ack", "config", "pattern",  # 5 Hz stream / sync replies
                   "programs_list", "debug", "pattern_event"}
_PROBLEM_EVENTS = {"error", "ready", "watchdog_timeout"}  # ready = controller restarted


@dataclass
class GunPattern:
    type: proto.PatternType = proto.PatternType.NONE
    elements: list[proto.PatternElement] = field(default_factory=list)
    # Per-gun total on-time budget (ms) measured from the start of Phase 1.
    # Dots mode: equals the droplet on-time. Lines mode: long safety ceiling
    # only -- line ends are encoder-position driven by PatternScheduler.
    on_timeout_ms: float = 1.2


@dataclass
class RuntimeConfig:
    pulses_per_mm: float       = 1.0
    min_speed_mm_s: float      = 100.0
    photocell_offset_mm: float = 250.0
    debounce_ms: int           = 20
    pick_current_a: float      = 1.0
    hold_current_a: float      = 0.4
    # 0 = primary fast 5V encoder (GPIO40), 1 = alternate 24V opto encoder
    # (GPIO5). Both are always counted in hardware; this only selects which
    # one drives pattern position tracking.
    encoder_source: int        = 0
    # Eye on INPUT1: False = a sheet is 24V present, True = a sheet is 0V.
    photocell_invert: bool     = False
    calib_paper_mm: float      = 297.0   # known sheet length for calibration


@dataclass
class LiveStatus:
    active: bool      = False
    fault: bool       = False
    calibrating: bool = False     # calibration mode: gluing stopped
    eye: bool         = False     # photocell sees a sheet (after invert)
    in1_24v: bool     = False     # 24V present on INPUT1 (electrical)
    speed_mm_s: float = 0.0
    sheet_count: int  = 0
    queue_depth: int  = 0


class AppState(QObject):
    # ---- signals consumed by widgets ----------------------------------------
    status_changed     = Signal(object)   # LiveStatus
    config_changed     = Signal(object)   # RuntimeConfig
    pattern_changed    = Signal(int, object)  # (gun_index_0based, GunPattern)
    log_appended       = Signal(dict)
    command_sent       = Signal(dict)      # outbound command payload
    connection_changed = Signal(bool, str)
    error_received     = Signal(str, str)  # (cmd, reason)
    programs_changed   = Signal(list)      # list of {id, name}
    calib_result       = Signal(float)     # pulses/mm from a finished calibration

    def __init__(self, link: LinkBase) -> None:
        super().__init__()
        self.link = link
        self.config   = RuntimeConfig()
        self.patterns = [GunPattern() for _ in range(proto.NUM_GUNS)]
        self.status   = LiveStatus()
        self.programs: list[dict[str, Any]] = []   # controller program index
        self.active_program_id: int = 0
        self.admin = AdminMode()                   # settings need the password
        # (active, fault, calibrating) last written to glue.log; None = unknown.
        self._logged_state: tuple[bool, bool, bool] | None = None

        link.event_received.connect(self._on_event)
        link.connection_changed.connect(self._on_link_conn)

        # Ping every 1s so the firmware watchdog stays fed and we measure RTT.
        self._ping_timer = QTimer(self)
        self._ping_timer.setInterval(1000)
        self._ping_timer.timeout.connect(self._ping)
        self._ping_timer.start()

    # ---- outbound (UI -> firmware) -----------------------------------------
    def _send(self, payload: dict[str, Any]) -> None:
        """Single funnel for outbound traffic so we can surface every command
        in the event log (the 1 Hz ping keep-alive is deliberately silent)."""
        cmd = payload.get("cmd")
        if cmd != "ping":
            if cmd in _ROUTINE_CMDS:
                LOGGER.debug("send: %s", payload)
            elif cmd == "set_pattern":
                # Full element list only in debug.log; editing sends many.
                LOGGER.info("send: set_pattern gun %s %s, %d elements",
                            payload.get("gun"), payload.get("type"),
                            len(payload.get("elements", [])))
                LOGGER.debug("send: %s", payload)
            else:
                LOGGER.info("send: %s", payload)
            self.command_sent.emit(payload)
        self.link.send(payload)

    def set_active(self, active: bool) -> None:
        self._send(proto.cmd_set_active(active))

    def push_config(self, **fields: float) -> None:
        """Apply local edits then publish them live."""
        for k, v in fields.items():
            if hasattr(self.config, k):
                setattr(self.config, k, type(getattr(self.config, k))(v))
        self.config_changed.emit(self.config)
        self._send(proto.cmd_set_config(**fields))

    def push_pattern(self, gun_index_0based: int) -> None:
        gp = self.patterns[gun_index_0based]
        self._send(proto.cmd_set_pattern(
            gun_1based=gun_index_0based + 1,
            ptype=gp.type,
            elements=gp.elements,
            on_timeout_ms=gp.on_timeout_ms,
        ))
        self.pattern_changed.emit(gun_index_0based, gp)

    def test_open(self, gun_1based: int, timeout_ms: int = 1000) -> None:
        self._send(proto.cmd_test_open(gun_1based, timeout_ms))

    def test_close(self, gun_1based: int = 0) -> None:
        self._send(proto.cmd_test_close(gun_1based))

    def calibrate(self, paper_length_mm: float) -> None:
        self._send(proto.cmd_calib_arm(paper_length_mm))

    def cancel_calibration(self) -> None:
        self._send(proto.cmd_calib_cancel())

    def sw_trigger(self) -> None:
        self._send(proto.cmd_sw_trigger())

    # ---- program store (controller is the source of truth) --------------------
    def request_programs(self) -> None:
        self._send(proto.cmd_list_programs())

    def load_program(self, program_id: int) -> None:
        self._send(proto.cmd_load_program(program_id))

    def save_program(self, program_id: int, name: str) -> None:
        self._send(proto.cmd_save_program(program_id, name))

    def rename_program(self, program_id: int, name: str) -> None:
        self._send(proto.cmd_rename_program(program_id, name))

    def delete_program(self, program_id: int) -> None:
        self._send(proto.cmd_delete_program(program_id))

    def reset_sheet_count(self) -> None:
        # The counter lives in the firmware; zero locally too for instant feedback.
        self._send(proto.cmd_reset_sheet_count())
        self.status.sheet_count = 0
        self.status_changed.emit(self.status)

    # ---- inbound (firmware -> UI) ------------------------------------------
    def _on_event(self, ev: dict[str, Any]) -> None:
        kind = ev.get("event", "")
        if kind in _ROUTINE_EVENTS:
            LOGGER.debug("event: %s", ev)
        elif kind in _PROBLEM_EVENTS:
            LOGGER.warning("event: %s", ev)
        else:   # calib_result, raw (boot banner / crash dump), unknown
            LOGGER.info("event: %s", ev)
        self.log_appended.emit(ev)
        if kind == proto.EVT_READY:
            # Firmware (re)booted and restored its active program from flash.
            self.request_state()
        elif kind == proto.EVT_STATUS:
            s = self.status
            s.active      = bool(ev.get("active", s.active))
            s.fault       = bool(ev.get("fault", s.fault))
            s.calibrating = bool(ev.get("calibrating", False))
            s.eye         = bool(ev.get("eye", False))
            s.in1_24v     = bool(ev.get("in1_24v", False))
            s.speed_mm_s  = float(ev.get("speed_mm_s", s.speed_mm_s))
            s.sheet_count = int(ev.get("sheet_count", s.sheet_count))
            s.queue_depth = int(ev.get("queue_depth", s.queue_depth))
            self._log_state_change(s)
            self.status_changed.emit(s)
        elif kind == proto.EVT_ERROR:
            self.error_received.emit(ev.get("cmd", ""), ev.get("reason", ""))
        elif kind == proto.EVT_CALIB_RESULT:
            ppm = ev.get("pulses_per_mm")
            if isinstance(ppm, (int, float)):
                self.config.pulses_per_mm = float(ppm)
                self.config_changed.emit(self.config)
                self.calib_result.emit(float(ppm))
        elif kind == proto.EVT_PROGRAMS_LIST:
            self.programs = ev.get("programs", [])
            self.active_program_id = ev.get("active_id", 0)
            self.programs_changed.emit(self.programs)
        elif kind == "config":
            self._apply_config_event(ev)
        elif kind == "pattern":
            self._apply_pattern_event(ev)

    def _apply_config_event(self, ev: dict[str, Any]) -> None:
        try:
            self.config.pulses_per_mm       = float(ev["pulses_per_mm"])
            self.config.min_speed_mm_s      = float(ev["min_speed_mm_s"])
            self.config.photocell_offset_mm = float(ev["photocell_offset_mm"])
            self.config.debounce_ms         = int(ev["debounce_ms"])
            self.config.pick_current_a      = float(ev["pick_current_a"])
            self.config.hold_current_a        = float(ev["hold_current_a"])
            self.config.encoder_source      = int(ev["encoder_source"])
            self.config.photocell_invert    = bool(ev.get("photocell_invert", False))
            self.config.calib_paper_mm      = float(ev.get("calib_paper_mm", 297.0))
            self.config_changed.emit(self.config)
        except (KeyError, ValueError, TypeError):
            pass

    def _apply_pattern_event(self, ev: dict[str, Any]) -> None:
        try:
            gun = int(ev["gun"]) - 1
            if not 0 <= gun < proto.NUM_GUNS:
                return
            t = ev.get("type", "none")
            gp = self.patterns[gun]
            gp.type = proto.PatternType(t) if isinstance(t, proto.PatternType) else proto.PatternType(t)
            gp.on_timeout_ms = float(ev.get("on_timeout_ms", 1.2))
            gp.elements = [
                proto.PatternElement(
                    float(el["start"]),
                    float(el["end"]),
                    float(el["spacing"]) if "spacing" in el else 0.0,
                )
                for el in ev.get("elements", [])
            ]
            self.pattern_changed.emit(gun, gp)
        except (KeyError, ValueError, TypeError):
            pass

    def request_state(self) -> None:
        """Pull config, every gun pattern and the program list from the
        controller. Never push local state here: the controller (and whatever
        the web UI changed on it) wins."""
        self._send(proto.cmd_get_state())

    def _log_state_change(self, s: LiveStatus) -> None:
        """Machine run state goes to glue.log only when it changes."""
        state = (s.active, s.fault, s.calibrating)
        if state == self._logged_state:
            return
        if s.fault:
            LOGGER.warning("machine: hardware fault")
        elif s.calibrating:
            LOGGER.info("machine: calibration mode")
        else:
            LOGGER.info("machine: %s", "active" if s.active else "stopped")
        self._logged_state = state

    def _on_link_conn(self, ok: bool, reason: str) -> None:
        if ok:
            LOGGER.info("connected: %s", reason)
        else:
            LOGGER.warning("disconnected: %s", reason)
            self._logged_state = None
        self.connection_changed.emit(ok, reason)
        if ok:
            self.request_state()

    def _ping(self) -> None:
        if self.link.connected:
            self.link.send(proto.cmd_ping())
