orkiman/glueControllerEsp32S3_48V/gui/ui/screens/configure.py

"""Settings screen — all knobs in one place:

  - Solenoid currents + hold time (operator-facing)
  - Global motion params (photocell offset, min speed, debounce, pulses/mm)
  - Encoder calibration
  - Event log (with CSV export) and the debug-mode switch (full file log)
"""
from __future__ import annotations

import csv
import json
from datetime import datetime
from pathlib import Path

from PySide6.QtWidgets import (QCheckBox, QComboBox, QFileDialog, QFormLayout,
                               QGridLayout, QGroupBox, QHBoxLayout, QLabel,
                               QPlainTextEdit, QPushButton, QVBoxLayout,
                               QWidget)

from app import logs
from app import protocol as proto
from app.state import AppState, LiveStatus, RuntimeConfig
from ui.widgets.admin_button import AdminButton
from ui.widgets.numeric_field import NumericField


class ConfigureScreen(QWidget):
    def __init__(self, state: AppState) -> None:
        super().__init__()
        self.state = state
        self._log_rows: list[tuple[str, dict]] = []

        # ---- Operation params (currents — global, all guns) ----------------
        max_pick = proto.MAX_PICK_CURRENT_A
        self.f_pick = NumericField("זרם משיכה (Pick)", "A", 0.1, max_pick, 0.05, 2)
        self.f_hold = NumericField("זרם החזקה (Hold)", "A", 0.05,
                                   proto.MAX_HOLD_CURRENT_A, 0.05, 2)
        self.f_pick.bind(lambda v: state.push_config(pick_current_a=v))
        self.f_hold.bind(lambda v: state.push_config(hold_current_a=v))

        op_box = QGroupBox("זרמי סולנואיד (גלובלי לכל האקדחים)")
        op_form = QFormLayout(op_box)
        op_form.addRow(self.f_pick)
        op_form.addRow(self.f_hold)

        # ---- Globals -------------------------------------------------------
        self.f_offset   = NumericField("מרחק עין מתחילת הדף", "mm",
                                       0.0, 2000.0, 1.0, 1)
        self.f_min_spd  = NumericField("מהירות מינ' לפעולה", "mm/s",
                                       0.0, 2000.0, 10.0, 0)
        self.f_debounce = NumericField("Debounce עין", "ms",
                                       0, 1000, 1, integer=True)
        self.f_offset  .bind(lambda v: state.push_config(photocell_offset_mm=v))
        self.f_min_spd .bind(lambda v: state.push_config(min_speed_mm_s=v))
        self.f_debounce.bind(lambda v: state.push_config(debounce_ms=int(v)))

        glob_box = QGroupBox("הגדרות גלובליות")
        glob_form = QFormLayout(glob_box)
        glob_form.addRow(self.f_offset)
        glob_form.addRow(self.f_min_spd)
        glob_form.addRow(self.f_debounce)
        # INPUT1 via TLP291: 24V on the input = GPIO1 low.  Default: a sheet
        # is 24V present; tick for a sensor that switches off at the sheet.
        self.chk_eye_invert = QCheckBox("הפוך לוגיקת עין (דף = אין 24V)")
        self.chk_eye_invert.setToolTip(
            "כבוי: העין מזהה דף כשיש 24V בכניסה 1.\n"
            "מסומן: העין מזהה דף כשאין 24V (חיישן שנכבה כשיש דף).\n"
            "אפשר לבדוק בכותרת: 'עין' נדלק כשדף מול העין.")
        self.chk_eye_invert.toggled.connect(
            lambda on: state.push_config(photocell_invert=bool(on)))
        glob_form.addRow(self.chk_eye_invert)

        # ---- Calibration ---------------------------------------------------
        self.f_ppm   = NumericField("Pulses / mm", "",
                                    0.01, 1000.0, 0.01, 4)
        self.f_paper = NumericField("אורך דף ידוע (לקליברציה)", "mm",
                                    10.0, 2000.0, 1.0, 1)
        self.f_ppm.bind(lambda v: state.push_config(pulses_per_mm=v))
        # Kept on the controller (shared with the web page and next runs).
        self.f_paper.bind(lambda v: state.push_config(calib_paper_mm=v))
        # Arms calibration mode; while the controller reports `calibrating`
        # the same button cancels it (see _on_status).
        self.btn_cal = QPushButton("דרוך קליברציה")
        self.btn_cal.clicked.connect(self._on_calib_button)
        self._calibrating = False

        # Encoder source: both encoders (GPIO40 fast 5V / GPIO5 alt 24V) are
        # always counted in hardware in parallel; this just selects which one
        # drives position tracking -- no reflash/rewiring needed to switch.
        self.cmb_encoder = QComboBox()
        self.cmb_encoder.addItem("5V מהיר (GPIO40)", 0)
        self.cmb_encoder.addItem("24V אופטו (GPIO5)", 1)
        self.cmb_encoder.currentIndexChanged.connect(
            lambda _i: state.push_config(
                encoder_source=self.cmb_encoder.currentData()))

        cal_box = QGroupBox("קליברציית אנקודר")
        cal_form = QFormLayout(cal_box)
        cal_form.addRow(self.f_ppm)
        cal_form.addRow(self.f_paper)
        cal_form.addRow(self.btn_cal)
        cal_form.addRow("מקור אנקודר", self.cmb_encoder)

        # ---- Event log -----------------------------------------------------
        self.log = QPlainTextEdit()
        self.log.setReadOnly(True)
        self.log.setMaximumBlockCount(2000)

        # Full traffic to debug.log.  Off at every start (see app/logs.py).
        self.chk_debug = QCheckBox("מצב דיבאג (לוג מלא לקובץ)")
        self.chk_debug.setChecked(logs.debug_enabled())
        self.chk_debug.setToolTip(
            f"רושם את כל התעבורה ל-{logs.debug_path()}\n"
            "נכבה והקובץ מתאפס בכל פתיחה של התוכנה.")
        self.chk_debug.toggled.connect(logs.set_debug)
        btn_clear  = QPushButton("נקה")
        btn_clear.clicked.connect(self._clear_log)
        btn_export = QPushButton("ייצוא CSV…")
        btn_export.clicked.connect(self._export_csv)
        log_actions = QHBoxLayout()
        log_actions.addWidget(self.chk_debug)
        log_actions.addStretch(1)
        log_actions.addWidget(btn_clear)
        log_actions.addWidget(btn_export)

        log_box = QGroupBox("יומן אירועים")
        log_lay = QVBoxLayout(log_box)
        log_lay.addWidget(self.log, 1)
        log_lay.addLayout(log_actions)

        # ---- Admin lock (settings only; the event log stays usable) ---------
        self.lbl_lock = QLabel()
        self.lbl_lock.setObjectName("StatCaption")
        lock_row = QHBoxLayout()
        lock_row.addWidget(self.lbl_lock)
        lock_row.addStretch(1)
        lock_row.addWidget(AdminButton(state.admin))
        self._locked_boxes = (op_box, glob_box)
        self._locked_cal = (self.f_ppm, self.f_paper, self.cmb_encoder)

        # ---- Compose -------------------------------------------------------
        top = QGridLayout()
        top.addWidget(op_box,   0, 0)
        top.addWidget(glob_box, 0, 1)
        top.addWidget(cal_box,  0, 2)

        root = QVBoxLayout(self)
        root.addLayout(lock_row)
        root.addLayout(top)
        root.addWidget(log_box, 1)

        state.admin.changed.connect(lambda _on: self._apply_lock())
        state.config_changed.connect(self._on_config)
        state.status_changed.connect(self._on_status)
        state.log_appended.connect(self._on_log)
        state.command_sent.connect(self._on_command_sent)
        self._on_config(state.config)
        self._apply_lock()

    # ---- handlers ----------------------------------------------------------
    def _on_config(self, c: RuntimeConfig) -> None:
        self.f_pick    .setValue(c.pick_current_a)
        self.f_hold    .setValue(c.hold_current_a)
        self.f_offset  .setValue(c.photocell_offset_mm)
        self.f_min_spd .setValue(c.min_speed_mm_s)
        self.f_debounce.setValue(c.debounce_ms)
        self.f_ppm     .setValue(c.pulses_per_mm)
        self.f_paper   .setValue(c.calib_paper_mm)
        self.chk_eye_invert.blockSignals(True)
        self.chk_eye_invert.setChecked(c.photocell_invert)
        self.chk_eye_invert.blockSignals(False)
        idx = self.cmb_encoder.findData(c.encoder_source)
        if idx >= 0 and idx != self.cmb_encoder.currentIndex():
            self.cmb_encoder.blockSignals(True)
            self.cmb_encoder.setCurrentIndex(idx)
            self.cmb_encoder.blockSignals(False)

    def _on_calib_button(self) -> None:
        if self._calibrating:
            self.state.cancel_calibration()
        else:
            self.state.calibrate(self.f_paper.value())

    def _on_status(self, s: LiveStatus) -> None:
        if s.calibrating != self._calibrating:
            self._calibrating = s.calibrating
            self.btn_cal.setText("בטל קליברציה" if s.calibrating else "דרוך קליברציה")
            self._apply_lock()

    def _apply_lock(self) -> None:
        admin = self.state.admin.active
        for w in (*self._locked_boxes, *self._locked_cal):
            w.setEnabled(admin)
        # Cancelling a running calibration is always allowed.
        self.btn_cal.setEnabled(admin or self._calibrating)
        self.lbl_lock.setText(
            "🔓  מצב מנהל — אפשר לשנות הגדרות. ננעל אוטומטית בסיום הזמן."
            if admin else
            "🔒  ההגדרות נעולות לשינוי. לשינוי: כניסת מנהל עם סיסמה.")

    def _is_routine(self, ev: dict) -> bool:
        """High-frequency, low-signal traffic that clutters the log:
        periodic status frames and the 1 Hz ping/ack keep-alive."""
        kind = ev.get("event", "")
        if kind == "status":
            return True
        if kind == "ack" and ev.get("cmd") == "ping":
            return True
        return False

    def _on_log(self, ev: dict) -> None:
        if self._is_routine(ev):     # full stream: debug mode -> debug.log
            return
        ts = datetime.now().strftime("%H:%M:%S.%f")[:-3]
        self._log_rows.append((ts, ev))
        self.log.appendPlainText(f"[{ts}] {json.dumps(ev, ensure_ascii=False)}")

    def _on_command_sent(self, cmd: dict) -> None:
        ts = datetime.now().strftime("%H:%M:%S.%f")[:-3]
        row = {"dir": "out", **cmd}
        self._log_rows.append((ts, row))
        self.log.appendPlainText(
            f"[{ts}] >> {json.dumps(cmd, ensure_ascii=False)}")

    def _clear_log(self) -> None:
        self._log_rows.clear()
        self.log.clear()

    def _export_csv(self) -> None:
        path, _ = QFileDialog.getSaveFileName(
            self, "ייצוא יומן", "events.csv", "CSV (*.csv)")
        if not path:
            return
        with Path(path).open("w", encoding="utf-8-sig", newline="") as f:
            w = csv.writer(f)
            w.writerow(["timestamp", "event_json"])
            for ts, ev in self._log_rows:
                w.writerow([ts, json.dumps(ev, ensure_ascii=False)])
