orkiman/glueControllerEsp32S3_48V/(commit log)

2026-05-10 Refactor: Move project out of kicad dir and setup hardware/firmware structure
    [bom.csv, coldGlueEsp32HardwareComperator080426.kicad_pcb, coldGlueEsp32HardwareComperator080426.kicad_sch, designators.csv, positions.csv]
2026-06-08 gui: add program store, command echo in log, overlap prevention, and fix enum coercion
    - Program store + selector bar: ProgramStore manages named profiles; ProgramBar
    widget in MainWindow restores last program on launch; apply_dict() helper
    extracted from load_from() for program switching.
    - Command echo: AppState._send() funnels outbound traffic (except 1 Hz ping)
    through new command_sent signal; ConfigureScreen displays >> prefixed lines
    with "dir":"out" in CSV export; "הצג סטטוס שוט
    [Config.h, configure.py, profiles.py, programs.py, protocol.py]
2026-06-23 docs: update project_status to Stage 2 feature-complete; fix test_open button, port persistence, and PatternType::None handling
    - Stage 2 status: "Feature complete" — mock-verified, pending first real-hardware run
    - GUI feature table: multi-program management, event log filtering, outbound command log, dynamic canvas, overlap prevention, Hebrew RTL fixes, encoder calibration, dark RTL theme
    - Test button: auto-release after timeout or error; "עצור בדיקה" / "בדיקה" toggle; "○ ל
    [UartJson.cpp, patterns.py, state.py]
2026-07-08 in the middle of fixing the test bug
    [Control.cpp, Dac.cpp, Dac.h, Events.cpp, Events.h, GunSequencer.cpp, GunSequencer.h, TestRunner.cpp]
2026-07-14 Ignore KiCAD generated files; remove view settings file from tracking
2026-07-15 gui: merge start/stop into toggle button, auto-connect on startup, and red bar when disconnected
    - OperateScreen: replace separate הפעל/עצור buttons with single toggle button that switches text/style based on active state; inactive state now shows red text instead of gray
    - ConnectionBar: auto-connect to last used port on startup and send set_active(true) after successful connection; apply bright red background to entire bar when disconnected for visibility; defer auto set_active with QTimer.
2026-07-20 firmware: synchronously set DAC pick threshold before energizing coil to prevent premature peak detection
    - Dac: add blockingSetCode() for synchronous single-channel write; introduce s_i2cMux semaphore to serialize chip access between dacTask and blockingSetCode(); guard writeAllChannels() with mutex
    - GunSequencer: call dac::blockingSetCode() in fire() before driving IN1 to ensure pick threshold is physically present on DAC output; prevents LM339 from tripping against stale near-zero threshold from previous cycle and
    [Dac.cpp, Dac.h, GunSequencer.cpp]
2026-08-03 gui: add encoder_source config field for runtime selection between primary and alternate encoder inputs
    - RuntimeConfig: add encoder_source field (0 = GPIO40 fast 5V, 1 = GPIO5 24V opto); default 0
    - protocol: include encoder_source in cmd_set_config() allowed fields
    - ConfigureScreen: add QComboBox for encoder selection with Hebrew labels; bind to push_config(); restore selection in load_from()
    - UartJson: parse encoder_source from set_config; validate ≤1; publish to cfg::Config
    - Encoder: count
2026-08-31 web: add gun test screen with 10-second auto-close and active state toggle
    - Add "בדיקה" tab with grid of 4 gun buttons; display pattern type on each button; disable if no pattern defined
    - Track activeTests Set and testTimers map; startTest() sends test_open with 10s timeout and schedules auto-close; stopTest() sends test_close and clears timer
    - Apply .testGun.active green background style when gun is firing; update testStatus message with active gun list
    - Load patterns on test screen activation; require active controller and web control before test; allow toggle on
2026-09-01 fix(test): allow 10 s test timeout to match web UI
    The gun test page sends timeout_ms=10000, but the dispatcher
    rejected anything above 5000 as bad_timeout. Raise the command
    limit and the sequencer hard ceiling to 10000 ms/us.
    Generated with [Devin](https://devin.ai)
    [CommandDispatcher.cpp, GunSequencer.cpp, TestRunner.cpp]
2026-09-01 feat(web/gui): encoder calibration on web + shorter test labels
    - Add `/api/calibrate` endpoint that arms encoder calibration and waits
    for the `calib_result` event, then returns the computed pulses/mm.
    - Add calibration input + button to the web settings page, wiring it to
    update the Pulses/mm field and save config automatically.
    - Shorten the per-gun toolbar button labels in the PC GUI so text fits
    at the default window width ("הוסף" / "עצור" instead of long phrases).
    - Extend protocol.py test_open timeout limit to 10000 ms to match the
    firmware limit.
    - Untrack Python __pycache__ files.
    Generated with [Devin](https://devin.ai)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
    [Events.cpp, Events.h, SoftAP.cpp, patterns.py, protocol.py]
2026-09-01 feat(web/gui): program sync, calibration, button labels
    - Add serial program-store commands (list/save/load/rename/delete) so the
    PC GUI can use the controller's SPIFFS program store instead of a local file.
    - Emit programs_list, config and pattern events from the firmware so the
    GUI updates automatically when a program is loaded.
    - Rewrite ProgramBar to list controller programs and switch between them.
    - Shorten per-gun toolbar button labels so they fit the default window size.
    - Add encoder calibration UI to the web settings page.
    - Change web UI acquire button text to "קבל שליטה פה".
    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
    [CommandDispatcher.cpp, Events.cpp, Events.h, patterns.py, protocol.py]
2026-09-01 fix(web/gui): program list sync and PC pattern editor refresh
    - Notify the serial link whenever a program is saved/renamed/deleted via the
    web endpoints, so the PC GUI program list updates live.
    - When loading a program via the web, also emit config + pattern events over
    serial so the PC GUI can refresh the active display.
    - Connect the PC GUI pattern editor to the pattern_changed signal so switching
    programs in the PC GUI actually redraws the canvas and toolbars.
    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
    [SoftAP.cpp, patterns.py]
2026-09-01 fix(firmware/gui): larger event buffer, logging, program error visibility
    - Increase serial emitter line buffer to 8192 bytes so full 64-element pattern
    events are not truncated; this fixes the PC GUI not redrawing a loaded
    program's patterns.
    - Add debug logging to run.py/state.py/program_bar.py so serial traffic and
    program operations can be traced from `gui/debug.log`.
    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
    [Events.cpp, run.py, state.py]
2026-10-02 feat(firmware/web/gui): shared PC + web control with live sync
    - Remove exclusive control ownership: the PC (UART) and the web page can both
    edit config, patterns and programs at the same time.
    - Allow saving, loading, renaming, deleting and autosaving programs while the
    machine is active.
    - Add comms/LiveSync: one edit lock for all config/program writers, a
    revision counter reported in /api/status, and push of web-side changes to
    the PC as config / pattern / programs_list events.
    - Add get_state serial command; the GUI pulls controller state on connect and
    after reboot instead of pushing its local defaults over the loaded program.
    - Web page reloads on revision change (skipping a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
    [CommandDispatcher.cpp, CommandDispatcher.h, Events.cpp, LiveSync.cpp, LiveSync.h, PatternScheduler.cpp, ProgramStore.cpp, ProgramStore.h]
2026-10-06 firmware/gui/web: min speed gates lines only; simplify encoder source labels
    - Speed-safety now applies to lines only: below min_speed_mm_s a line is
    not opened, but dots fire at any speed.
    - Line close (seq::abort) always runs, so a speed drop mid-line no longer
    leaves the gun open until the 5 s safety ceiling.
    - Drop primary/alternate wording from encoder source options in the
    PC GUI and web page; keep the 5V/24V/GPIO details.
    [PatternScheduler.cpp, configure.py]
2026-10-06 firmware: lines min-speed pause/resume with fast speed gate
    - Lines mode: if speed drops below min_speed_mm_s mid-line the gun closes
    immediately and re-opens if speed recovers while still inside the line
    region. A line started below min speed opens once speed recovers.
    - Speed gate polls the PCNT count every ~1 ms (no per-pulse interrupts)
    and logs count changes with poll timestamps. "Too slow" = no pulse for
    longer than one pulse period at min speed, or upper speed bound over the
    last 30 ms below min. "Resume" = lower bound >= 105 % of min. Ambiguous
    readings hold the current state (no chatter).
    - Displayed speed is now a 300 ms sliding window sampled every 10 ms.
    - Not yet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
    [PatternScheduler.cpp]
2026-10-06 firmware/gui/web: sheet counter; GUI run controls moved into header
    Firmware
    - Count photocell leading edges accepted while active and not faulted.
    Reported as sheet_count in the UART status event and GET /api/status.
    - New command reset_sheet_count (UART and web /api/command).
    Web
    - Operate screen shows the sheet count with a reset button.
    GUI
    - Remove the Operate screen. Start/stop toggle, state, speed and sheet
    count (with reset) now sit compactly in the header row next to the
    connection status; the whole row still turns red when disconnected.
    - Reset button sends reset_sheet_count so PC and web share one counter.
    - Sidebar replaced by tabs (Program / Settings) to give the editor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
    [CommandDispatcher.cpp, Control.cpp, Control.h, Events.cpp, Events.h, PatternScheduler.cpp, PatternScheduler.h, SoftAP.cpp]
2026-10-06 firmware: fix reboot-to-inactive crash -- make all ISR paths IRAM-safe
    Symptom: controller suddenly showed "inactive". It was rebooting with
    "Guru Meditation Error: Core 1 panic'ed (Cache disabled but cached memory
    region accessed)" a few seconds after settings/pattern edits. The edit
    triggers a flash save on Core 0 (cache off); a photocell / PCNT / peak /
    fault ISR firing then (IRAM ISRs keep running) touched flash and panicked.
    Backtrace: gpio ISR -> cfg::Config::active() (in flash).
    Fix -- nothing reachable from an ISR lives in flash any more:
    - cfg::Config::active(), evt::postFromISR/invokeCb -> IRAM_ATTR.
    - Per-gun pin tables (DRV_IN1, MUX_IN2, MUX_SELECT, PEAK_IRQ) -> DRAM_ATTR
    (c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
    [Driver.cpp, Encoder.cpp, Events.cpp, Fault.cpp, GunSequencer.cpp, PatternScheduler.cpp, Pins.h]
2026-10-09 firmware: RT safety supervisor and hardware drop-end timer
    Every drop now has three independent ways to close, none depending on a
    task:
    - Close alarm: hardware timer (TIMERG0) interrupt on Core 1 at the exact
    on-time end. Replaces the esp_timer callback, which ran in a system task
    on Core 0 below Wi-Fi priority and stalled during flash writes.
    - Supervisor: 50 us hardware timer (TIMERG1) interrupt on Core 1 closes any
    drop past its end.
    - Core 0 checker (esp_timer, 1 ms): last resort 2 ms after the end; also
    restarts the supervisor tick if it ever stops.
    The close is armed before IN1 goes high.
    Supervisor safety rules (IRAM, run during flash writes too):
    - Pick limit: hold thresho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
    [Config.h, Control.cpp, Dac.cpp, Dac.h, GunSequencer.cpp, GunSequencer.h, PatternScheduler.cpp]
2026-10-09 firmware: fire on the encoder pulse, close lines in the supervisor
    The pattern task used to check the encoder once per 1 ms FreeRTOS tick, so
    a drop could fire up to ~1 ms late (up to ~1.7 mm at 100 m/min).
    - The task publishes each gun's next due pulse; the 50 us supervisor tick
    compares it with the encoder and wakes the task at that pulse. The task
    waits on a notification (1 ms timeout for the speed gate and display)
    instead of vTaskDelay(1).
    - A line's end pulse is armed when it opens; the supervisor closes the gun
    there itself, so the line ends on time even if the task is late or a
    flash write holds it.
    - A new photocell sheet wakes the task too.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
2026-10-09 firmware: DAC pick pre-arm, single-channel writes, safe power-on value
    - When a drop's decay ends, the pick threshold goes onto the DAC. fire()
    only writes I2C if it is not there yet (drop right after a close, config
    change), so a normal drop starts with GPIO writes only instead of a
    ~250 us blocking I2C write per gun that stacked when guns fired together.
    - DAC writes only the channels that changed: Multi-Write for one or two
    channels (4 / 7 bytes instead of 9), Fast Write for three or four.
    Still 400 kHz. Direct Wire access; the Adafruit MCP4728 / BusIO
    libraries are no longer used.
    - Failed writes are retried at once and then every tick until applied;
    i2c_write_failed is r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
    [CommandDispatcher.cpp, Config.h, Dac.cpp, GunSequencer.cpp, GunSequencer.h, ProgramStore.cpp]
2026-10-09 gui/web: show safety trips; pick limited to 1.5 A
    - PC GUI: firmware safety trips (error gunN/<reason>) appear in the status
    bar in Hebrew; a safety stop stays until the next message. A rejected
    pick above the limit gets its own message.
    - Web: /api/status trips counter; the page shows the last trip when it
    changes.
    - Pick input max 1.5 A, hold max 1.45 A in both (firmware limit).
    [configure.py, protocol.py]
2026-10-09 docs: real-time safety supervisor, timing, DAC pre-arm; bring-up checklist
2026-10-10 firmware: time-based supervisor stall check; rt_ticks in status
    First boot on the controller reported 10 false tick_stalled errors during
    Wi-Fi init. esp_timer runs late periodic callbacks back to back, so the
    Core 0 checker ran three times within microseconds and saw no new tick.
    The stall check now uses real time: no tick for 3 ms.
    Status (UART event and /api/status) reports rt_ticks, the supervisor tick
    count; measured on the controller: ~19,400 per second.
    [Events.cpp, Events.h, GunSequencer.cpp, GunSequencer.h, SoftAP.cpp, Status.cpp]
2026-10-12 docs: lines min-speed pause/resume verified on the conveyor; drop TO CHECK item
2026-10-12 gui/web/firmware: operator alert explaining safety trips and stops
    A gun configured (e.g. lines) but not connected never reaches pick current,
    trips pick_timeout three times and the machine stops -- correct, but the
    only hint was a short status-bar line (GUI) or a 3.5 s message (web).
    - GUI: new alert banner under the header. Single trip: amber, 15 s, says
    what happened and what to check. Safety stop: red, names the gun and the
    cause, stays until closed or the machine is started again.
    - Web: same alert at the top of the page with the same wording.
    - Firmware: /api/status reports stop_cause (the trip that triggered the
    last safety_stop) so the web page can explain the stop, not just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
2026-10-13 gui: standalone .exe build for the machine computer
    - build_exe.ps1: PyInstaller one-file, no console, bundles ui/styles.qss
    (the old README command left the theme out). Output:
    gui/dist/GlueController.exe (~47 MB, no Python needed on the target).
    - run.py: when frozen, write debug.log next to the .exe (the one-file temp
    folder is deleted on exit); cap the log at 3 x 5 MB (status events are
    logged at 5 Hz, ~80 MB/day unbounded).
    - README: build steps and machine-computer install notes (SmartScreen,
    CP210x driver, nothing else to copy).
    - .gitignore: PyInstaller build/dist/spec and rotated logs.
    Tested: the built .exe starts with the dark theme, auto-connects to COM13
    and logs nex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
2026-10-13 gui: small always-on log of important events; full traffic only in debug mode
    The single log recorded every status event (5 Hz) and every sync reply --
    millions of lines, useless for finding what happened.
    - glue.log (always on, 3 x 1 MB): connect/disconnect, machine active /
    stopped / hardware fault (only when it changes), operator commands
    (set_pattern summarised), controller errors and safety trips, controller
    restarts and raw boot/crash output, calibration results.
    - debug.log (debug mode only): everything, including the status stream,
    acks and full pattern payloads. Toggled from File > debug mode or
    --debug; off at every start, and the file is cleared when the program
    open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
2026-10-13 gui: remove profile load/save from the File menu
    Programs live on the controller (program bar). The JSON profile import
    also overwrote calibration and currents with no confirmation, and its name
    was confusing next to programs. Remove the menu items, profiles.py and the
    unused PC-side programs.py store (dead since programs moved to the
    controller).
2026-10-13 gui: debug-mode switch moves to Settings; remove the File menu
    The File menu only held debug mode and Exit (window close does the same).
    Debug mode is now a checkbox in the Settings tab's event-log box, next to
    the live-status toggle; tooltip shows the debug.log path.
2026-10-13 firmware/gui/web: calibration mode with indication and state restore
    Arming calibration used to leave the machine running (sheets in flight and
    later sheets still glued), gave no indication, never restored anything, and
    the web call blocked 15 s then reported failure while the controller stayed
    armed -- a later sheet would silently change pulses_per_mm.
    - calib_arm enters calibration mode: remember active/inactive, stop gluing
    like set_active:false, report "calibrating" in status and /api/status.
    - One sheet: pulses from the photocell rising to falling edge -> apply and
    save pulses_per_mm, calib_result, restore the previous state. No pulses
    -> error calib_arm/no_pulses, cali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
2026-10-13 firmware/gui/web: fix inverted photocell logic; show eye state; invert option
    INPUT1 drives a TLP291 whose collector pulls GPIO1 low (RN2 10k pull-up),
    so 24V on the input = GPIO1 LOW. The firmware took GPIO1 rising -- the 24V
    going away -- as the sheet's leading edge: patterns started at the sheet's
    trailing edge and calibration measured the gap between sheets.
    - A sheet = 24V present on INPUT1 by default. New config photocell_invert
    (set_config, config event, /api/config, saved with the program; optional
    on load) for a sensor that switches off at the sheet. ISR stays IRAM-
    clean (check_isr_iram.py OK).
    - status / /api/status report eye (sees a sheet) and in1_24v (electri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
2026-10-13 gui: open the serial port without resetting the controller
    DTR/RTS drive the ESP32 auto-reset (EN / IO0) through the CP2102. pyserial
    asserts them when it opens the port, so every connect -- app start, a USB
    reconnect, wake from sleep, switching ports -- restarted the controller and
    stopped the machine mid-run. Open with both released.
    Tested with the rebuilt exe: open, close, open again -- no 'ready' event,
    the controller keeps running (before: 'ready' on every open).
2026-10-13 firmware/gui/web: operator-set gun test duration, up to 30 s
    - Firmware: test_open accepts timeout_ms 1..30000 (was 10000); the
    sequencer's longest single opening (MAX_ON_US) is 30 s. Production never
    comes near it (lines 5 s ceiling, dots ms), so only tests use the range.
    Close alarm (1 MHz, 32-bit) covers it. IRAM check clean.
    - GUI: "משך בדיקה" (1-30 s) above the gun boxes on the program screen, used
    by every gun's test button; kept between runs (QSettings, default 5 s).
    - Web: duration field on the test screen (1-30 s, kept per browser); the
    fixed "10 seconds" text is gone.
    Built and checked in the mock (test button sends the set duration and stays
    pressed for it) an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
2026-10-13 firmware/gui/web: gun tests only while the machine is stopped
    Reverses the old rule (tests needed the machine active).
    - test_open is refused while active (machine_active) or calibrating.
    - Test drops use seq::fire(..., test=true): allowed only in test mode
    (set by the test runner) with the machine stopped, never when faulted.
    Production drops still need the machine active.
    - Starting the machine or calibration stops running tests.
    - The link watchdog now also covers a running test (2 s without PC / web
    contact stops it); a safety stop ends test mode.
    - GUI and web: test buttons enabled only while stopped; a running test is
    released when the machine starts.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
2026-10-13 firmware/gui/web: remember calibration length, admin mode, 100 mm canvas
    Calibration sheet length
    - New config calib_paper_mm (default 297), kept on the controller: set by
    the GUI / web field, sent in config and /api/config, saved with the
    program (optional on load). The field no longer resets.
    Admin mode (password 1234, shown in the prompt -- only against accidental
    changes)
    - GUI: Settings (currents, globals, eye logic, calibration) locked unless
    admin; 10 minutes with a countdown; enter / exit from the header or the
    Settings tab. Programs, patterns, start/stop, tests and the event log
    stay open; cancelling a running calibration is always allowed.
    Disabled fields now look di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
2026-10-13 gui/web: admin mode also locks program editing and tests
    Without admin only choosing a program, start/stop, the sheet-counter reset
    and the event log stay open (plus stopping a running test / cancelling a
    running calibration). Locked now as well: program save / save-as / new /
    delete, pattern type, segments (editor view-only: no drag, add, wheel,
    right-click delete), drop size, gun tests and the test duration. Admin
    button also on the Program tab; on the web it moves to the top of every
    screen and locks the programs, patterns and test screens too.
    Checked in the mock (locked / admin / relocked) and the web logic in the
    browser. Firmware unchanged except the web page; built, IRAM check cl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
2026-10-13 gui: remove the plain Save button (edits autosave on the controller)
    Save as / New / Delete stay.
2026-10-18 gui/web: start/stop button stays blue; strong running / stopped colours
    - State shown as a solid pill: green "פעיל" while running, red "לא פעיל"
    while stopped (red fault, blue calibration).
    - Full-width colour strip: under the GUI header, at the top of the web page.
    - The start/stop button no longer turns red while running.
2026-10-18 firmware/gui/web: limit hold current to 0.5 A
    - Firmware: cfg::MAX_HOLD_CURRENT_A = 0.5; set_config above it fails
    hold_too_high; programs saved with more load capped to 0.5 A (like the
    pick limit).
    - GUI: hold field max 0.5 A; status-bar message on hold_too_high.
    - Web: hold input max 0.5.
    Built, IRAM check clean, GUI compiles, exe rebuilt. Not flashed (the
    controller is at the machine).
